j-silv/FPGA-based-Sudoku/schematics/bemicromax10_j5_pinout.PNG

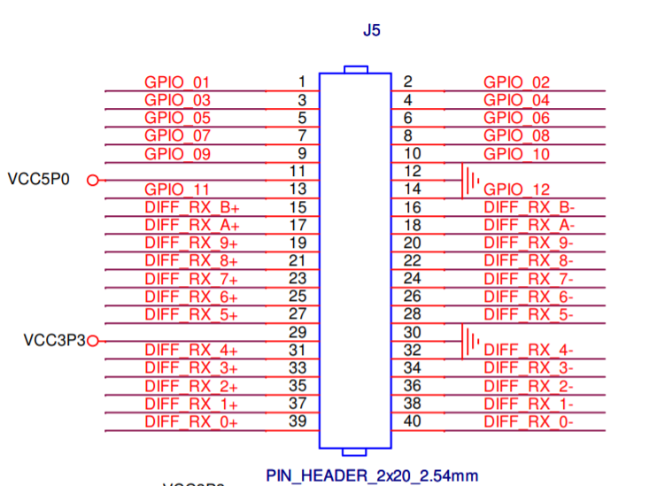
schematics/bemicromax10_j5_pinout.PNG
