j-silv/FPGA-based-Sudoku/altium/Source/Project Outputs for sudoku/png/sudoku_3d_top.png

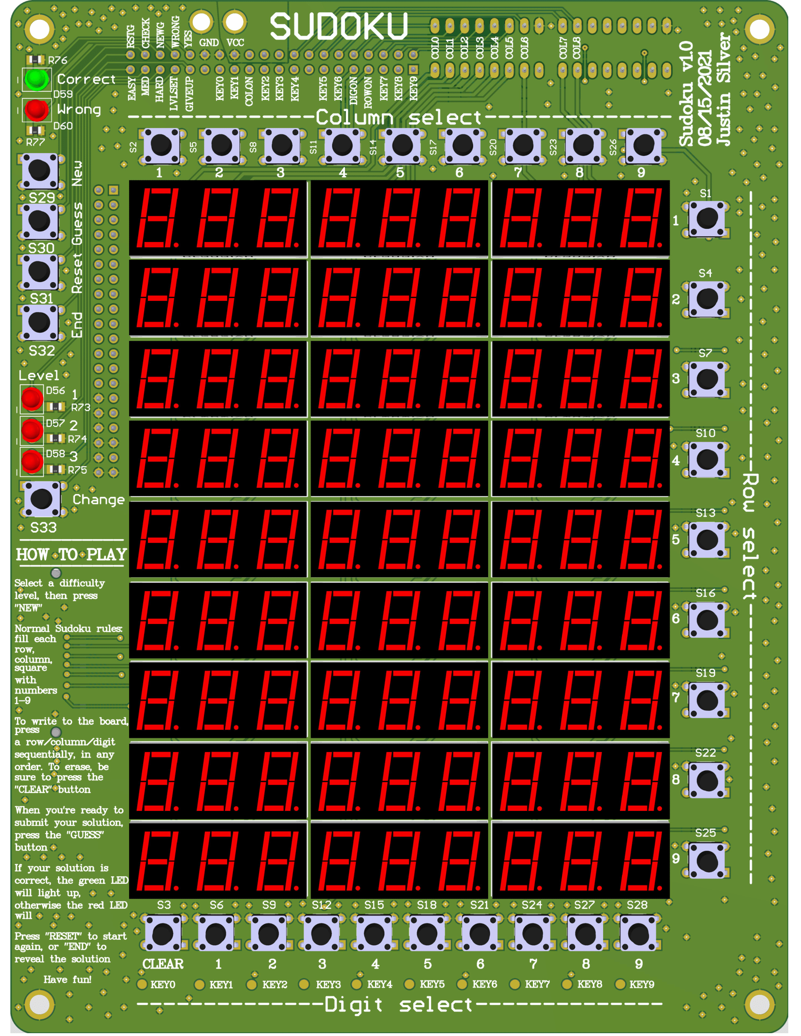
altium/Source/Project Outputs for sudoku/png/sudoku_3d_top.png
