j-silv/FPGA-based-Sudoku/README.md

# FPGA-based-Sudoku
Here you will find HDL, Quartus II, and LTspice files for my Intel MAX 10 FPGA-based Sudoku game.
