j-silv/FPGA-based-Sudoku/schematics/README.txt

This folder contains the schematic files for the Sudoku design.
When opened in Quartus II, these .bdf files show the HDL components connected together.
