j-silv/FPGA-based-Sudoku/LTspice/README.txt

In this folder, you will find circuit simulation (LTspice) files for various components of the Sudoku design
