j-silv/FPGA-based-Sudoku/HDL/README.txt

This folder contains the HDL files for each component in the Sudoku design (RAM, encoders, counters, etc.)
