j-silv/FPGA-based-Sudoku/symbols/README.txt

This folder contains the Quartus II symbol files that are created from their associated HDL files.
These symbols are used to create the .bdf schematics found in the schematics/ folder.
