j-silv/FPGA-based-Sudoku/scripts/pins/README.txt

This folder contains the pin assignment files for the Sudoku design. These assignments are made using TCL script files
that are executed via the Quartus II software.

For this project, the pins are set for a MAX 10 10M08DAF484 FPGA development board.
