j-silv/FPGA-based-Sudoku/altium/Source/Project Outputs for sudoku/png/sudoku_3d.png

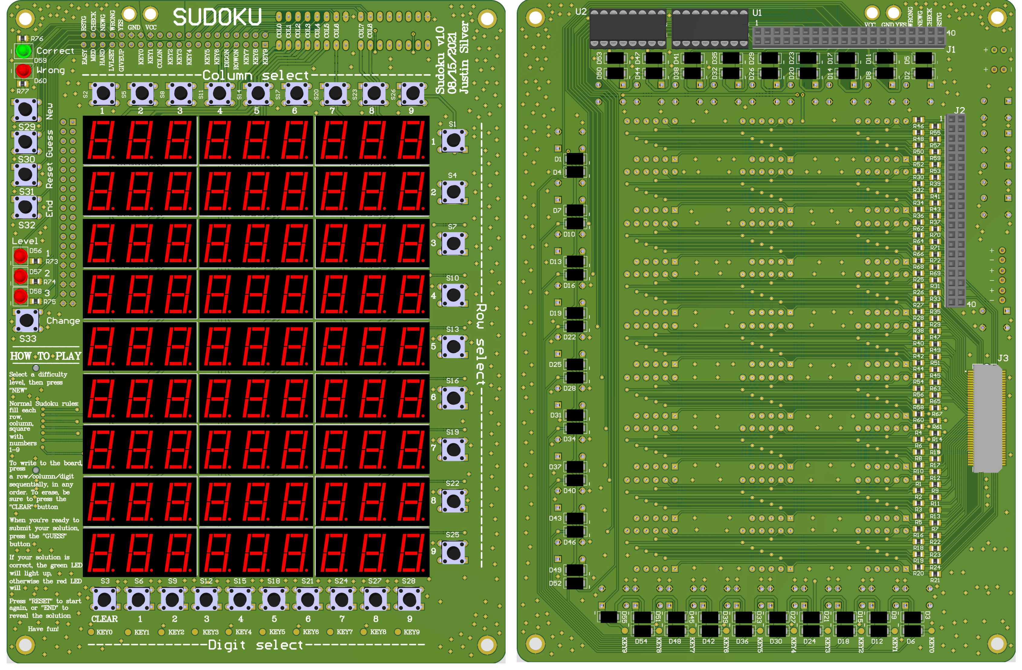
altium/Source/Project Outputs for sudoku/png/sudoku_3d.png
