j-silv/FPGA-based-Sudoku/altium/Source/Project Outputs for sudoku/png/sudoku_3d_and_2d_pcb.png

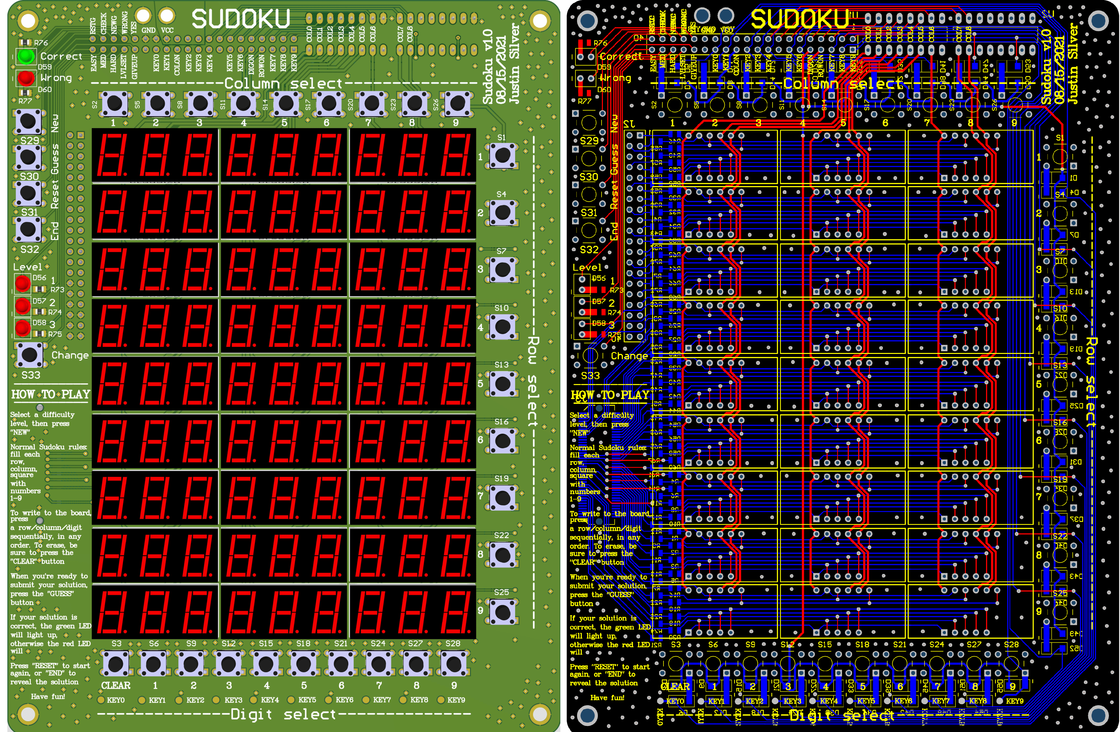
altium/Source/Project Outputs for sudoku/png/sudoku_3d_and_2d_pcb.png
