j-silv/FPGA-based-Sudoku/altium/Source/Project Outputs for sudoku/png/sudoku_3d_bot.png

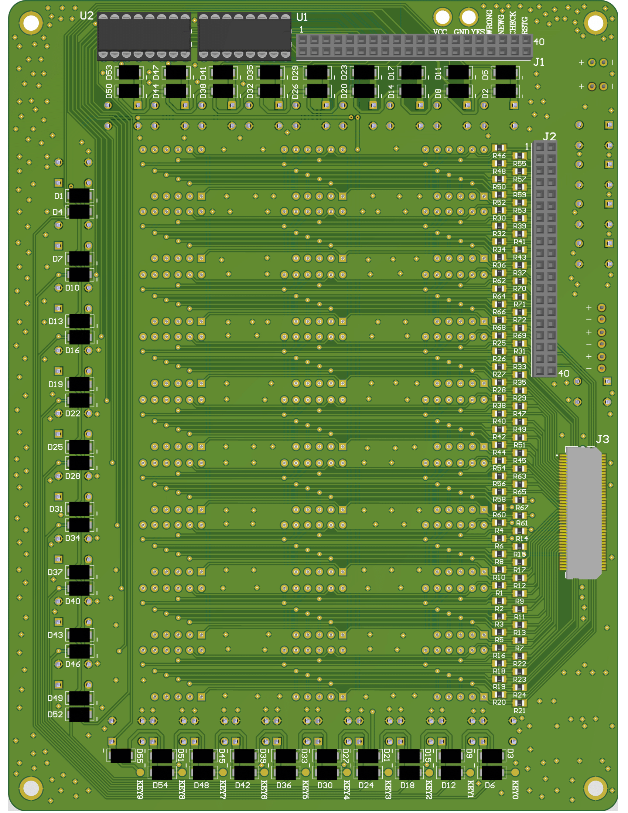
altium/Source/Project Outputs for sudoku/png/sudoku_3d_bot.png
