j-silv/FPGA-based-Sudoku/altium/Source/Project Outputs for sudoku/png/sudoku_all_nopoly_side.png

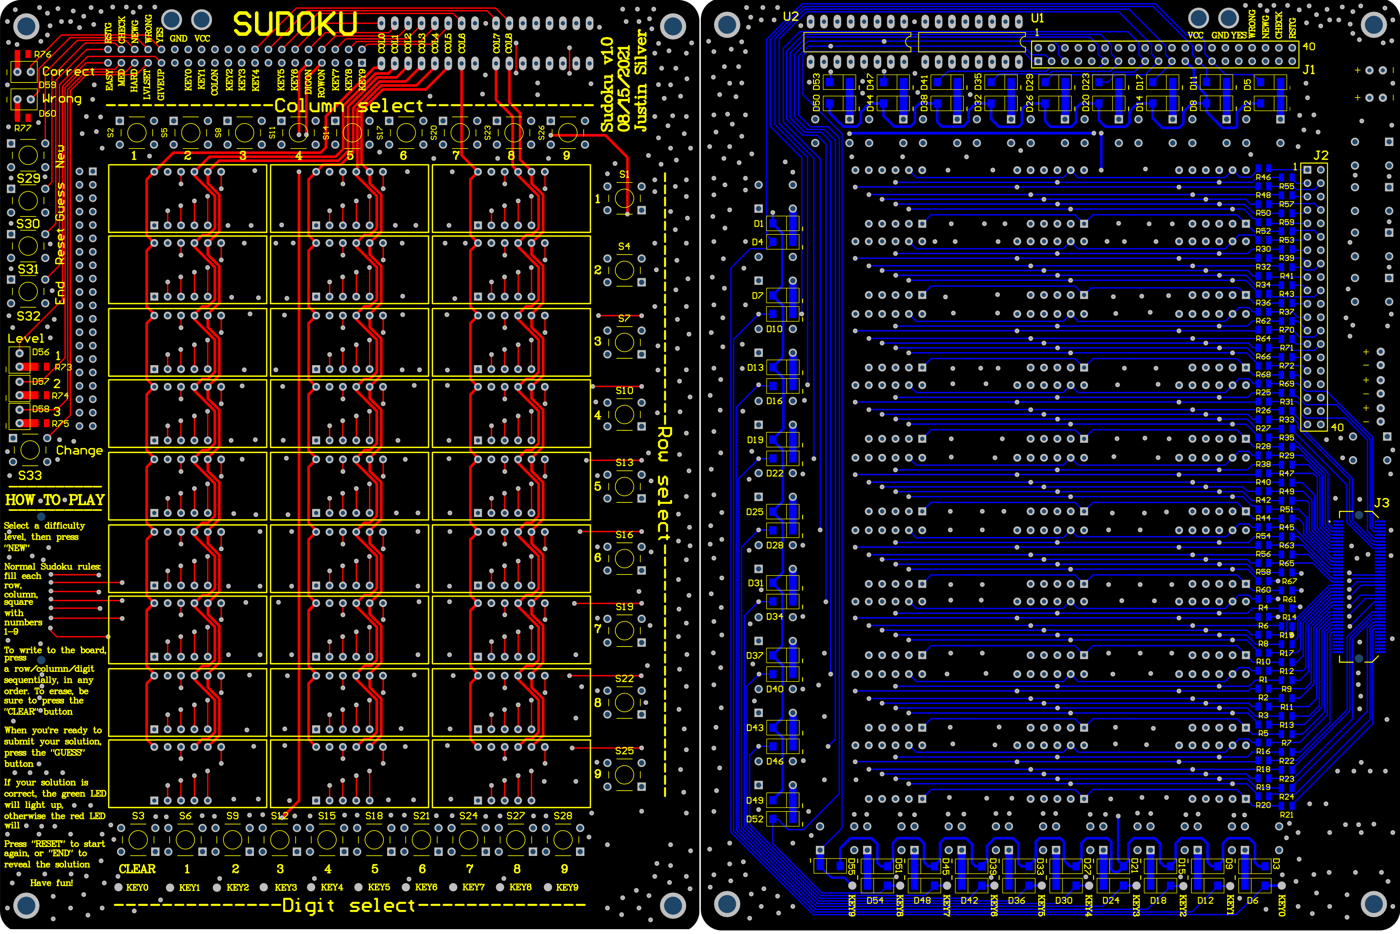
altium/Source/Project Outputs for sudoku/png/sudoku_all_nopoly_side.png
