j-silv/FPGA-based-Sudoku/altium/Source/Project Outputs for sudoku/png/sudoku_bot_nopoly.png

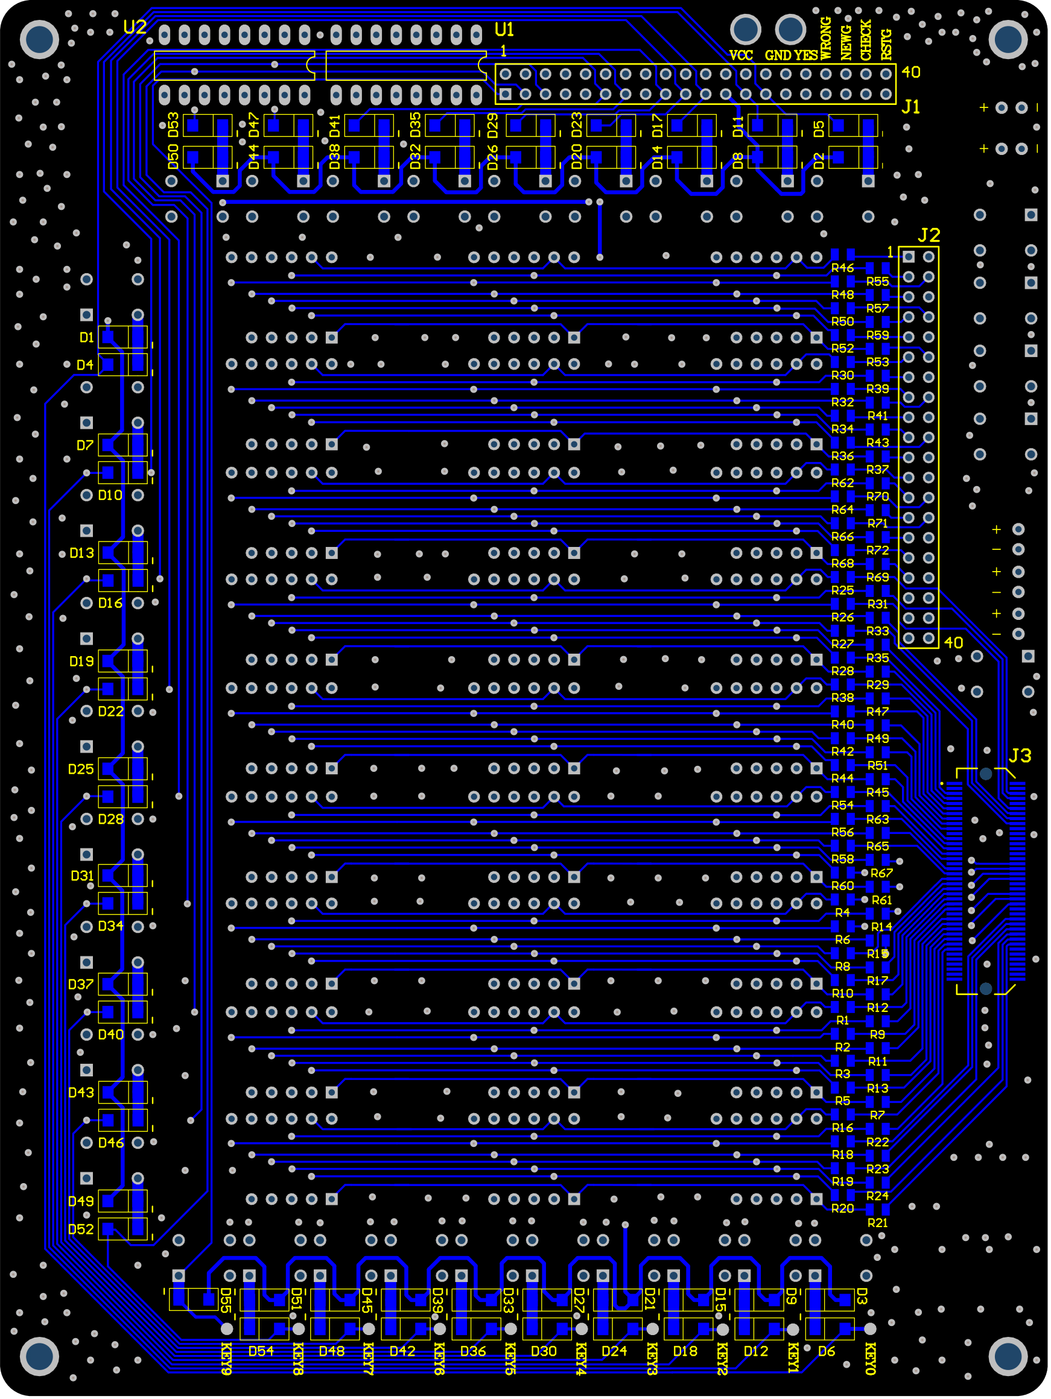
altium/Source/Project Outputs for sudoku/png/sudoku_bot_nopoly.png
