j-silv/FPGA-based-Sudoku/altium/Source/Project Outputs for sudoku/png/sudoku_bot_poly.png

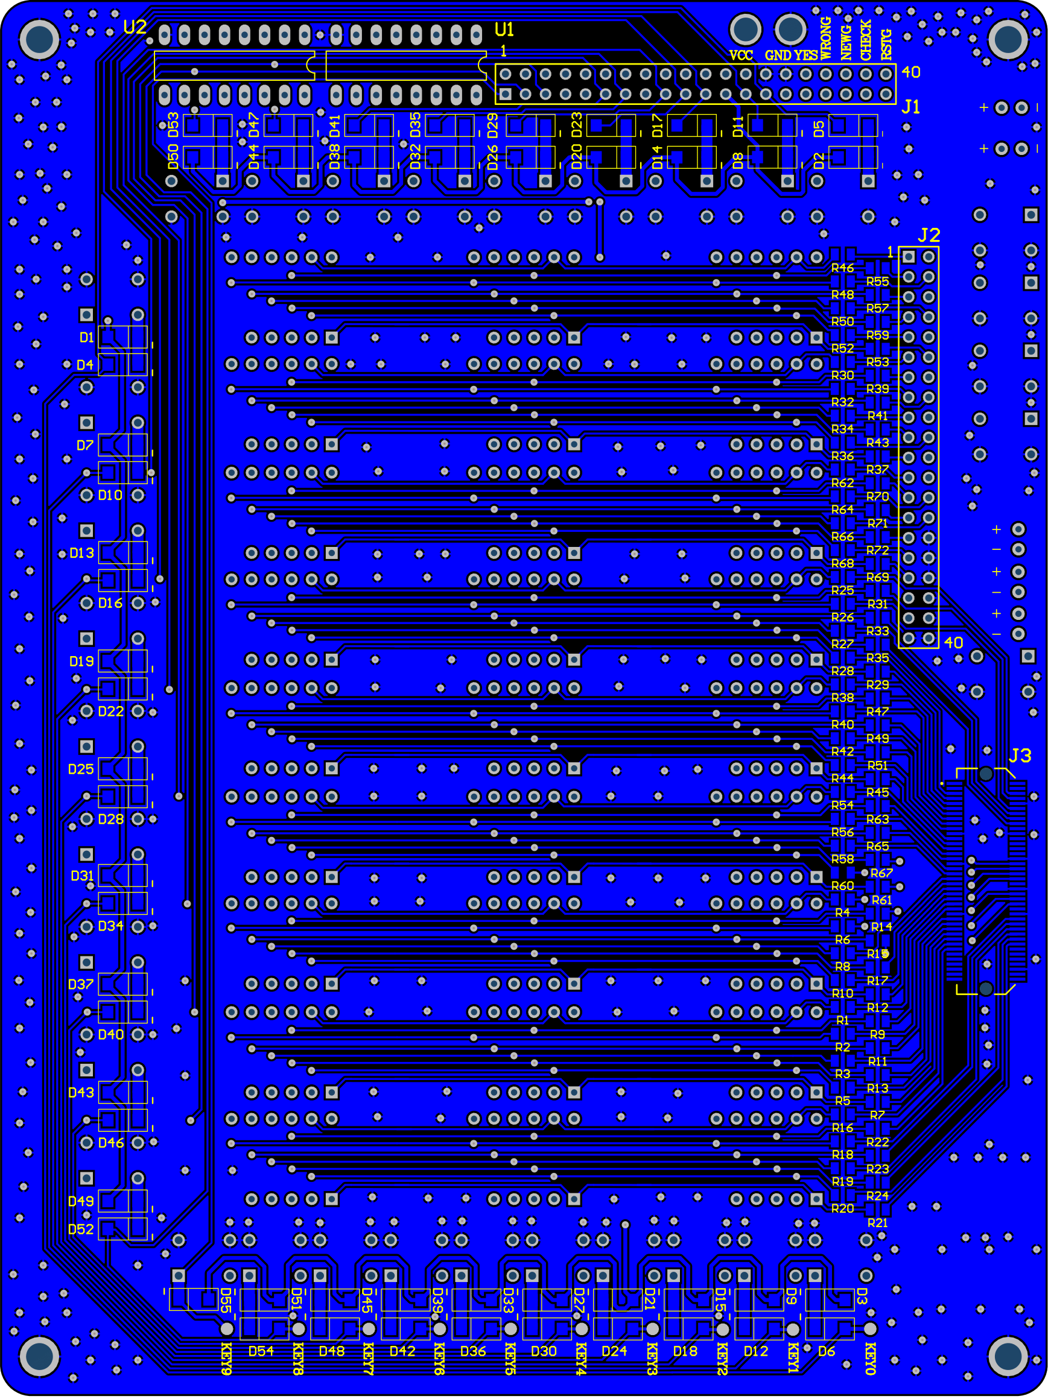
altium/Source/Project Outputs for sudoku/png/sudoku_bot_poly.png
