j-silv/FPGA-based-Sudoku/altium/Source/Project Outputs for sudoku/png/sudoku_fpga_connectors.png

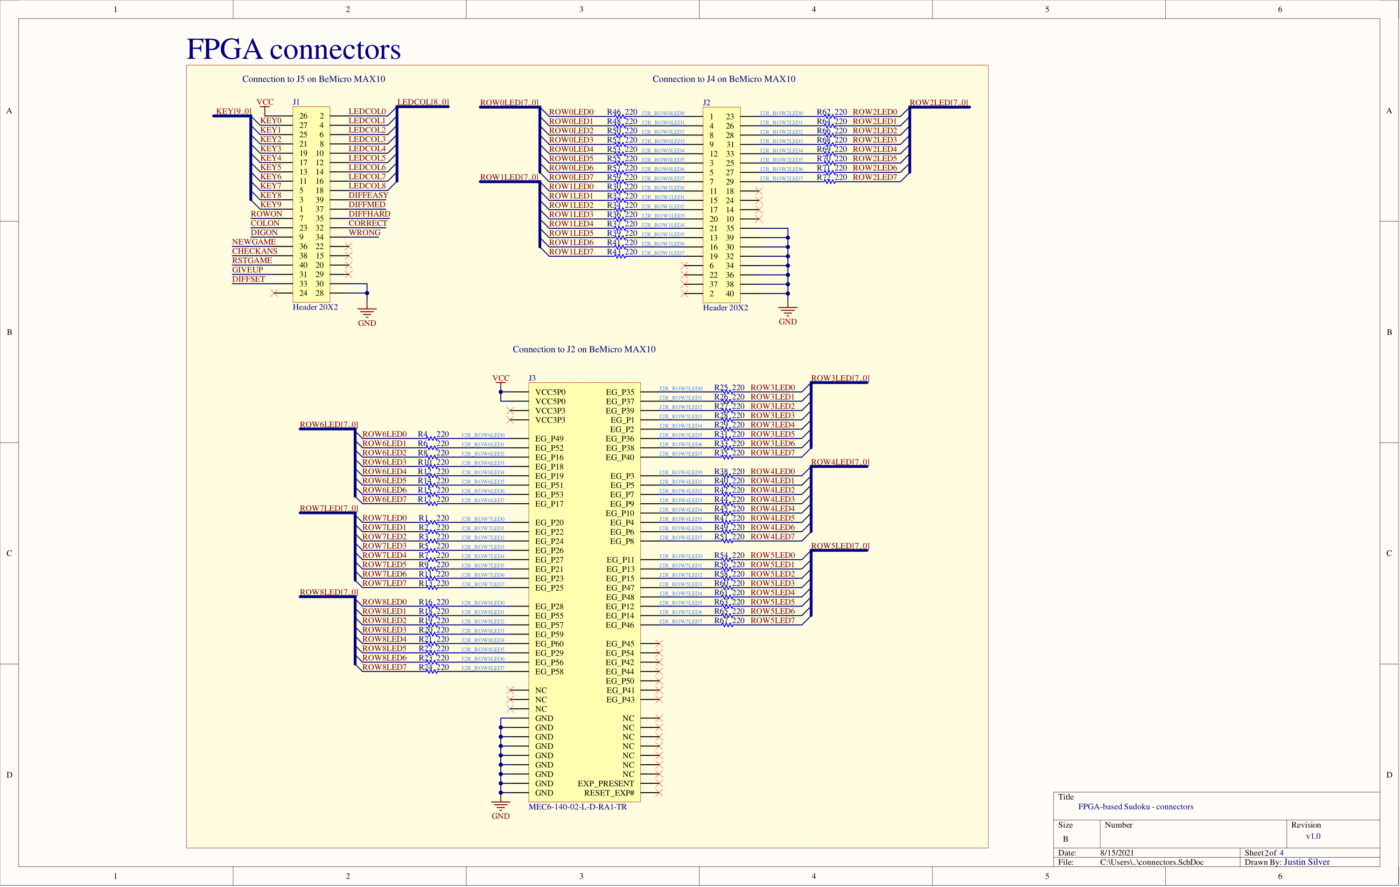
altium/Source/Project Outputs for sudoku/png/sudoku_fpga_connectors.png
