j-silv/FPGA-based-Sudoku/altium/Source/Project Outputs for sudoku/png/sudoku_grid_display.png

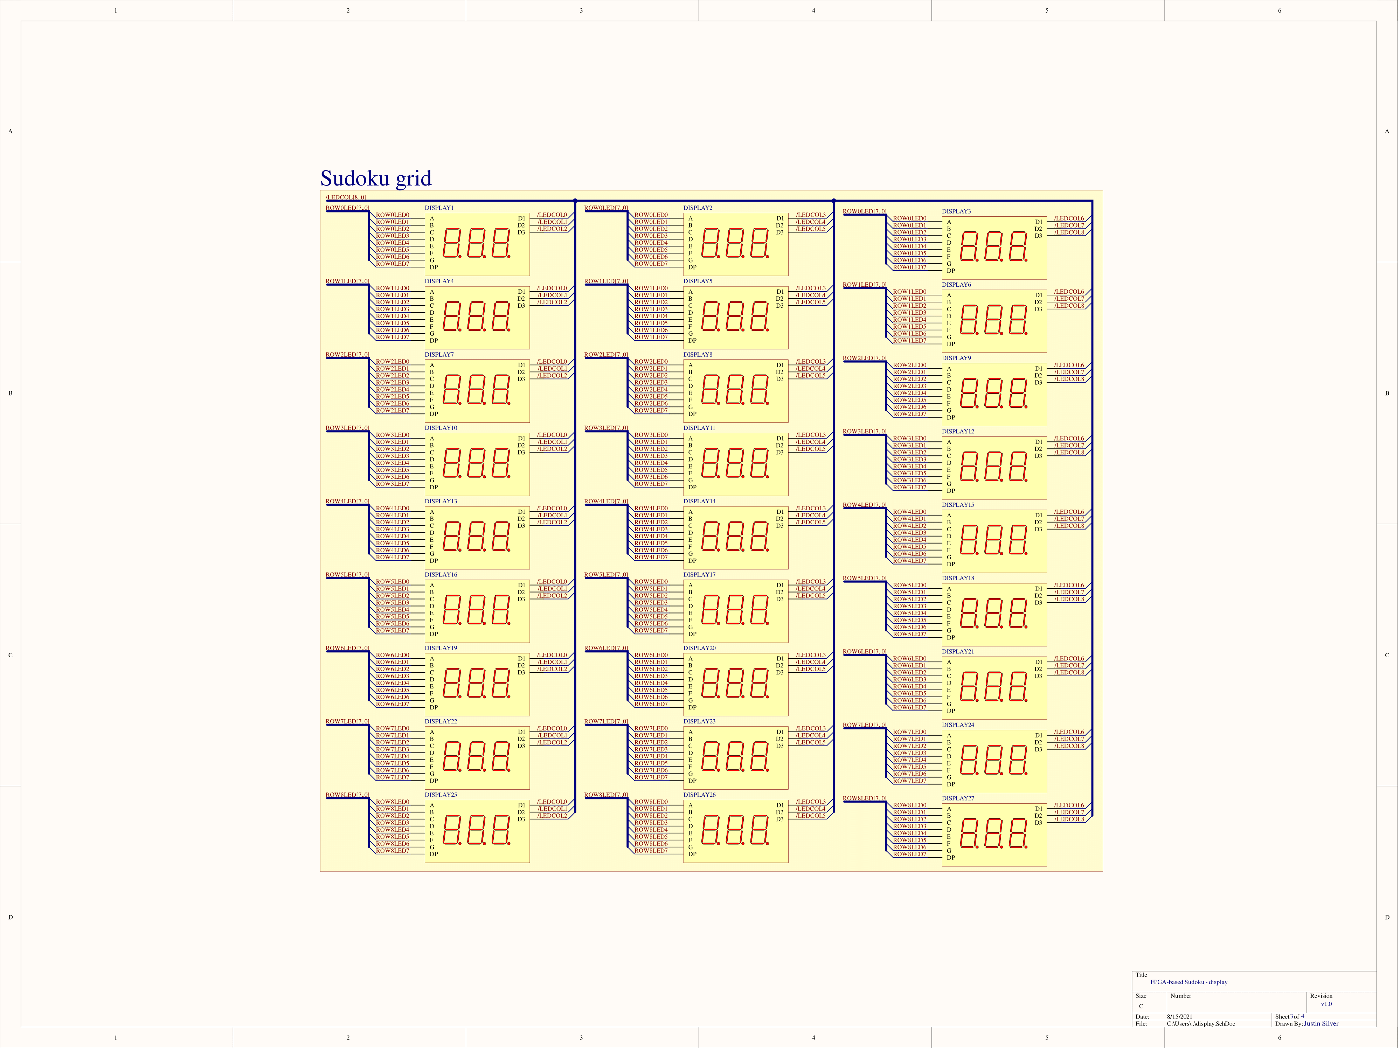
altium/Source/Project Outputs for sudoku/png/sudoku_grid_display.png
