j-silv/FPGA-based-Sudoku/altium/Source/Project Outputs for sudoku/png/sudoku_keyboard.png

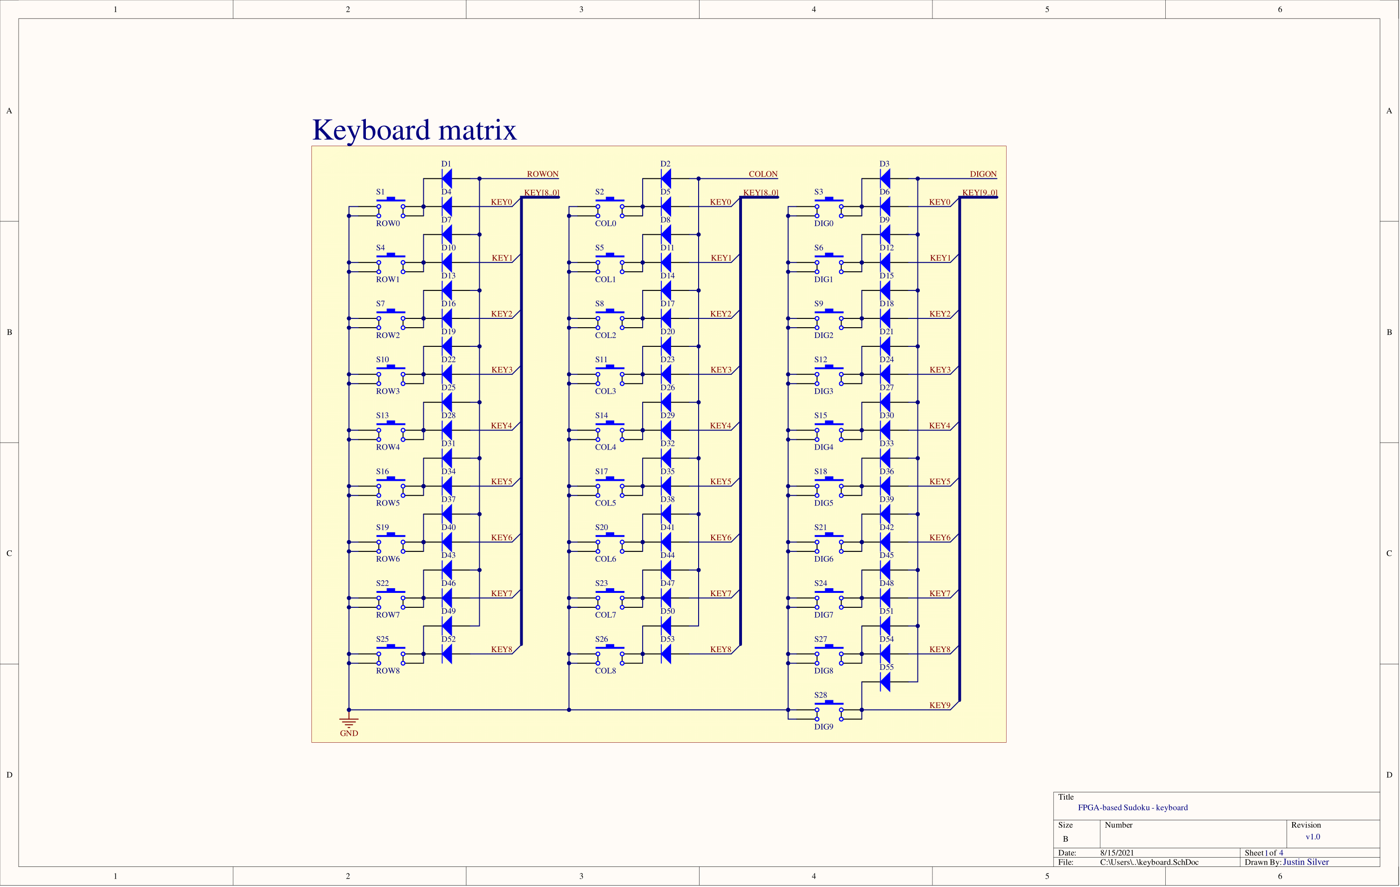
altium/Source/Project Outputs for sudoku/png/sudoku_keyboard.png
