j-silv/FPGA-based-Sudoku/altium/Source/Project Outputs for sudoku/png/sudoku_misc.png

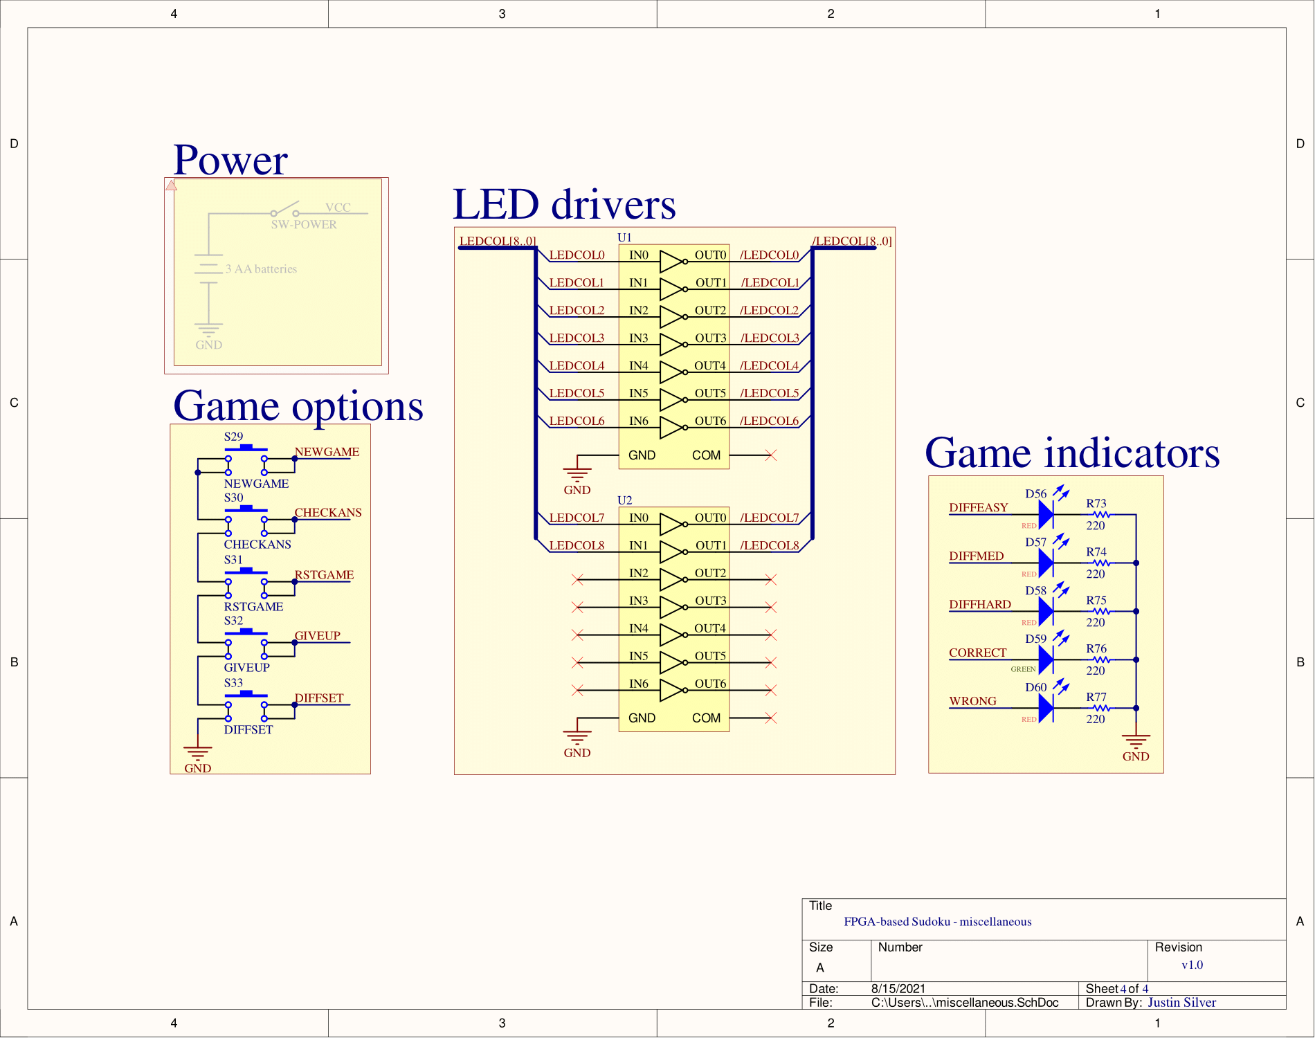
altium/Source/Project Outputs for sudoku/png/sudoku_misc.png
