j-silv/FPGA-based-Sudoku/altium/Source/Project Outputs for sudoku/png/sudoku_top_poly.png

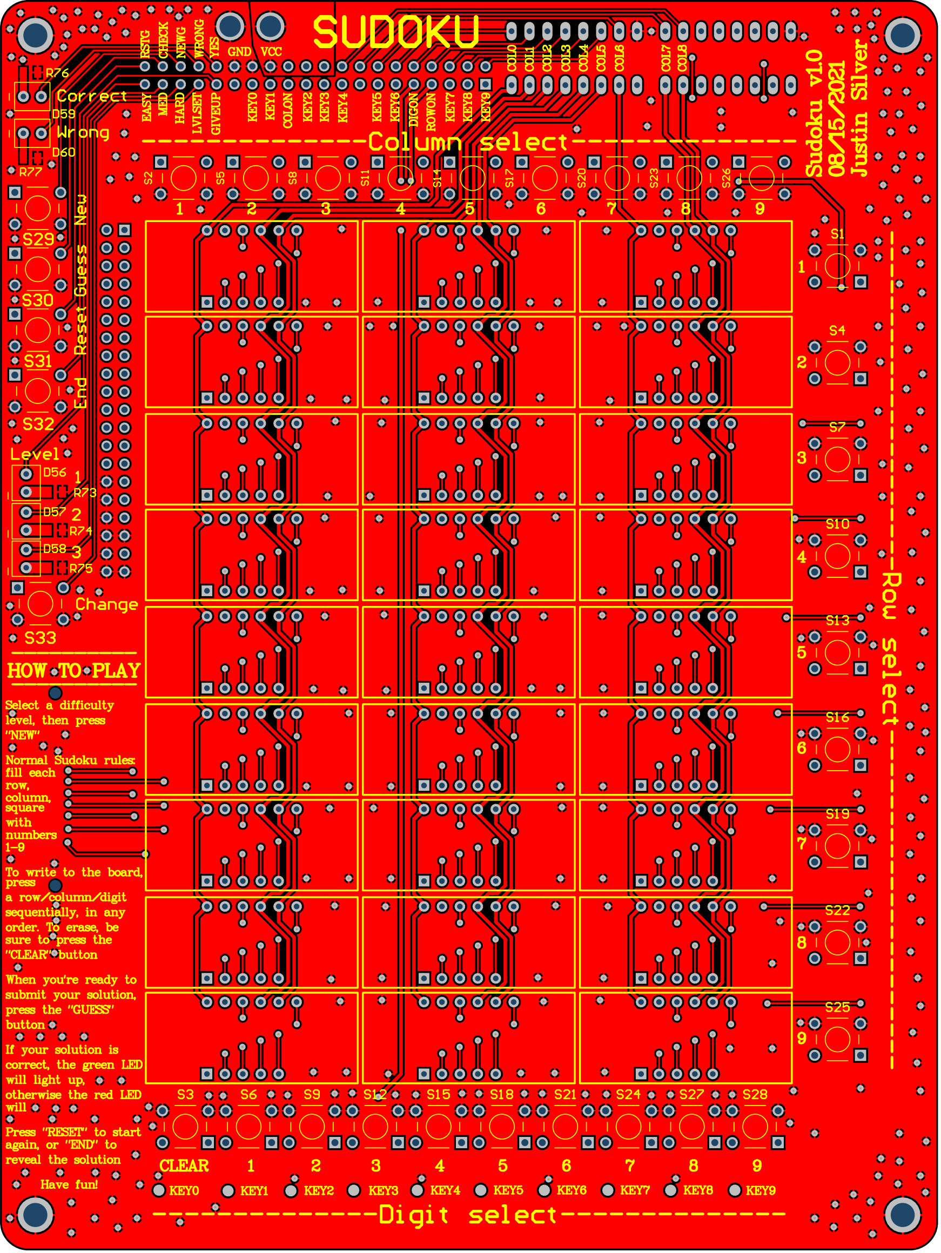
altium/Source/Project Outputs for sudoku/png/sudoku_top_poly.png
