j-silv/FPGA-based-Sudoku/schematics/bemicromax10_j4_pinout.PNG

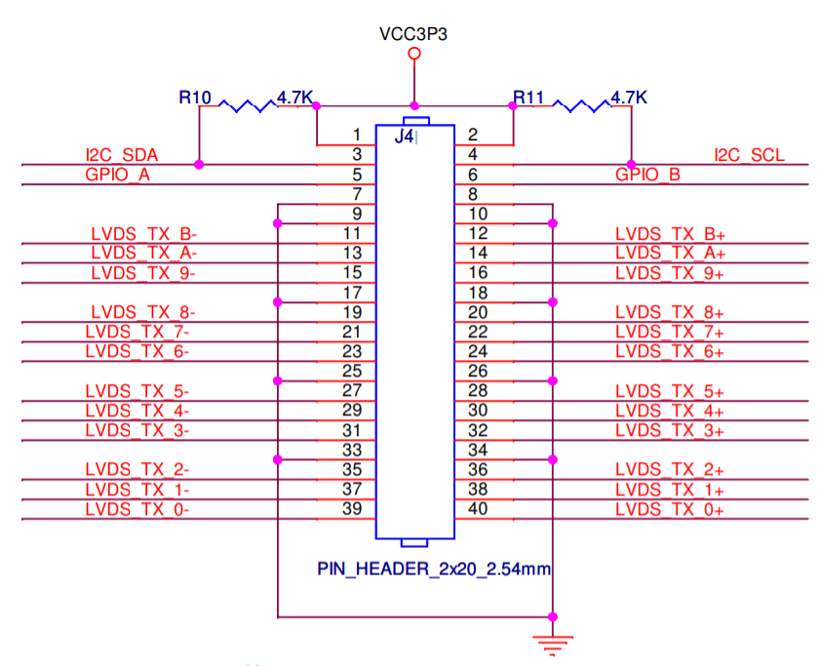
schematics/bemicromax10_j4_pinout.PNG
