j-silv/FPGA-based-Sudoku/testbenches/README.txt

This folder contains testbench code for simulating and testing the Sudoku design in ModelSim (Altera).
