j-silv/FPGA-based-Sudoku/debug/README.txt

This folder contains the various files needed to debug/test the Sudoku design with actual hardware
