j-silv/FPGA-based-Sudoku/altium/Source/Project Outputs for sudoku/schematic/sudoku.PDF

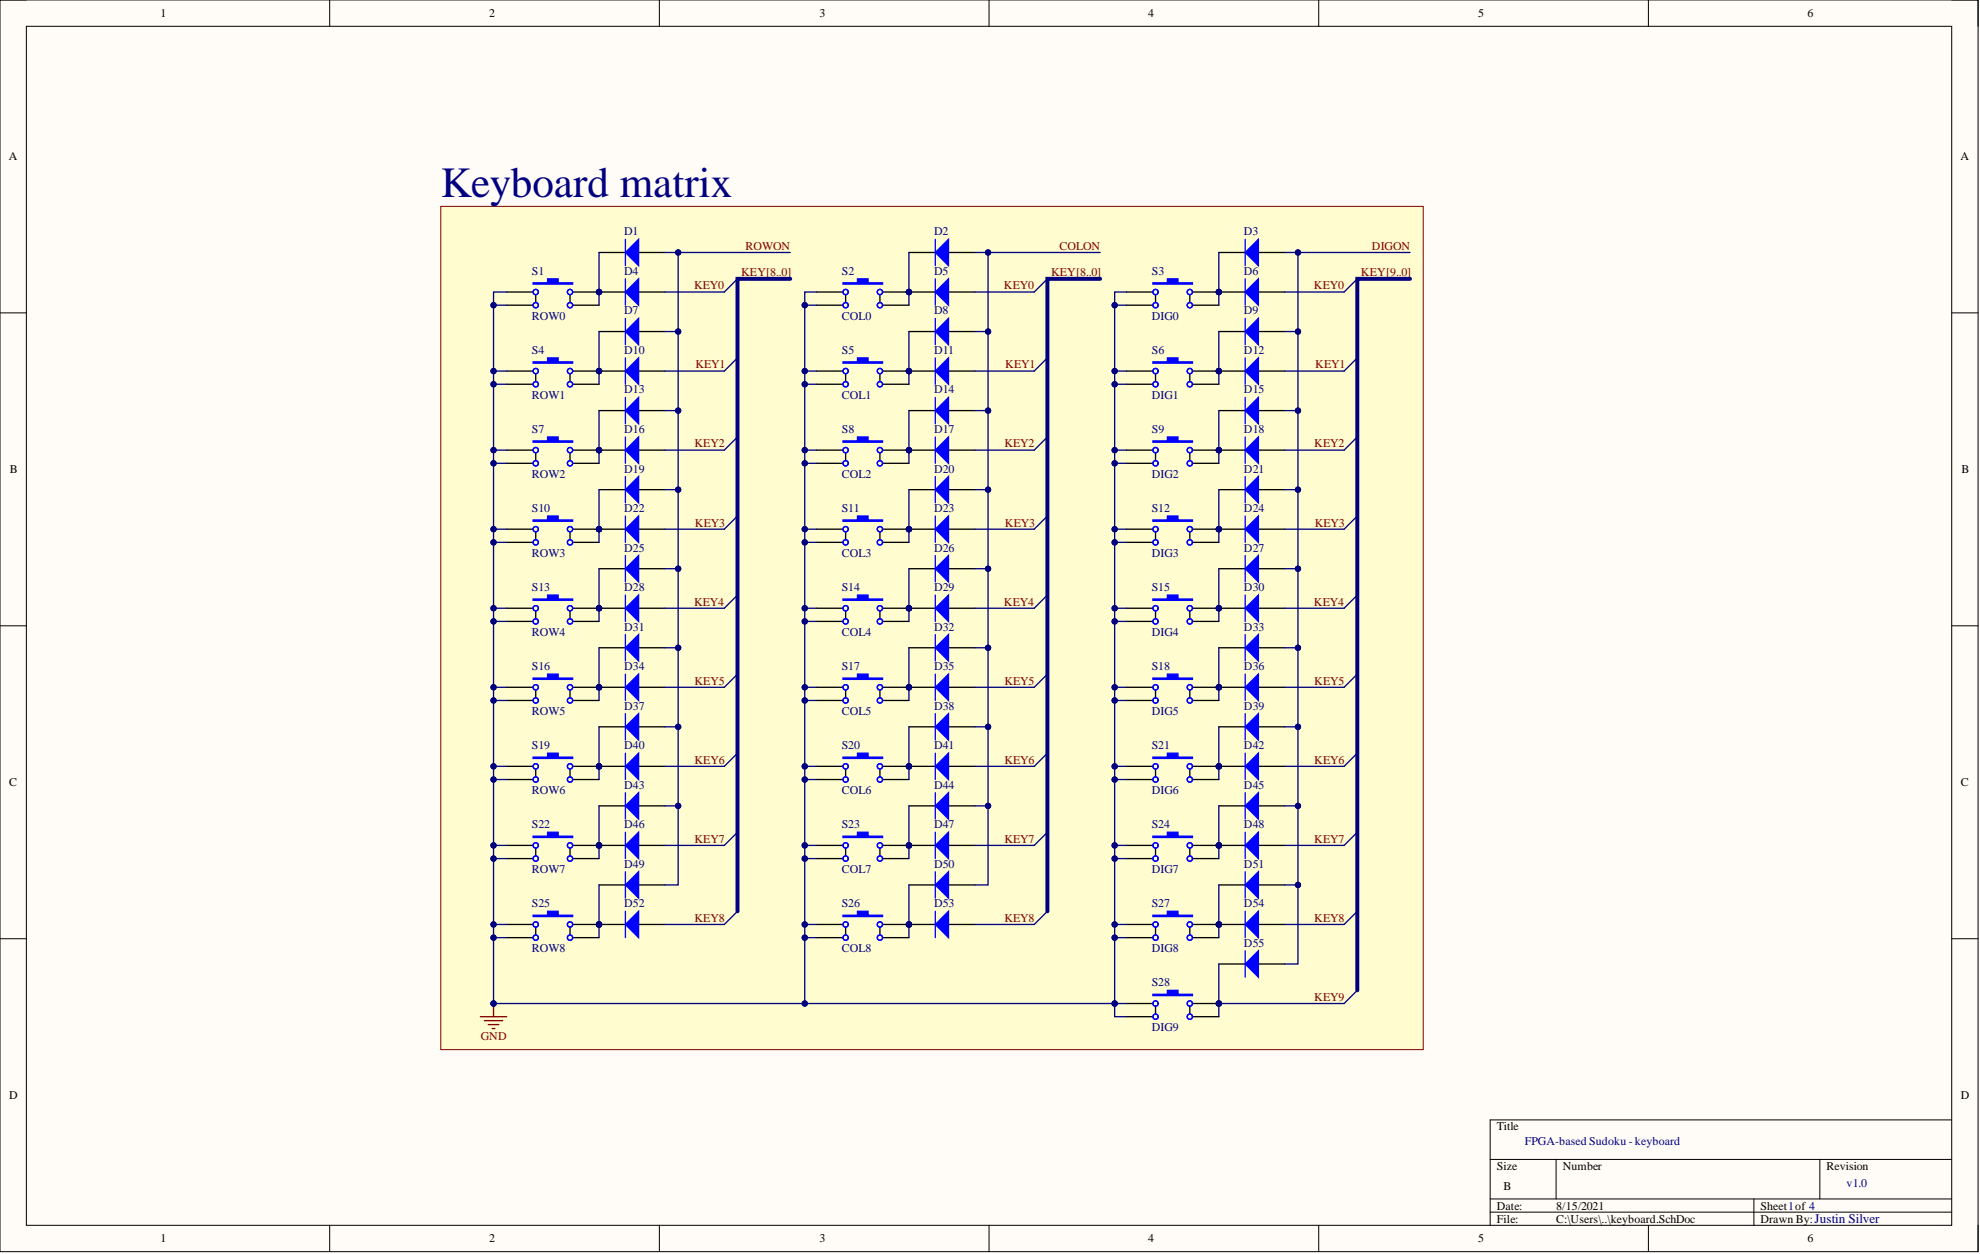
[picture p18: page 1]

Title
FPGA-based Sudoku - keyboard

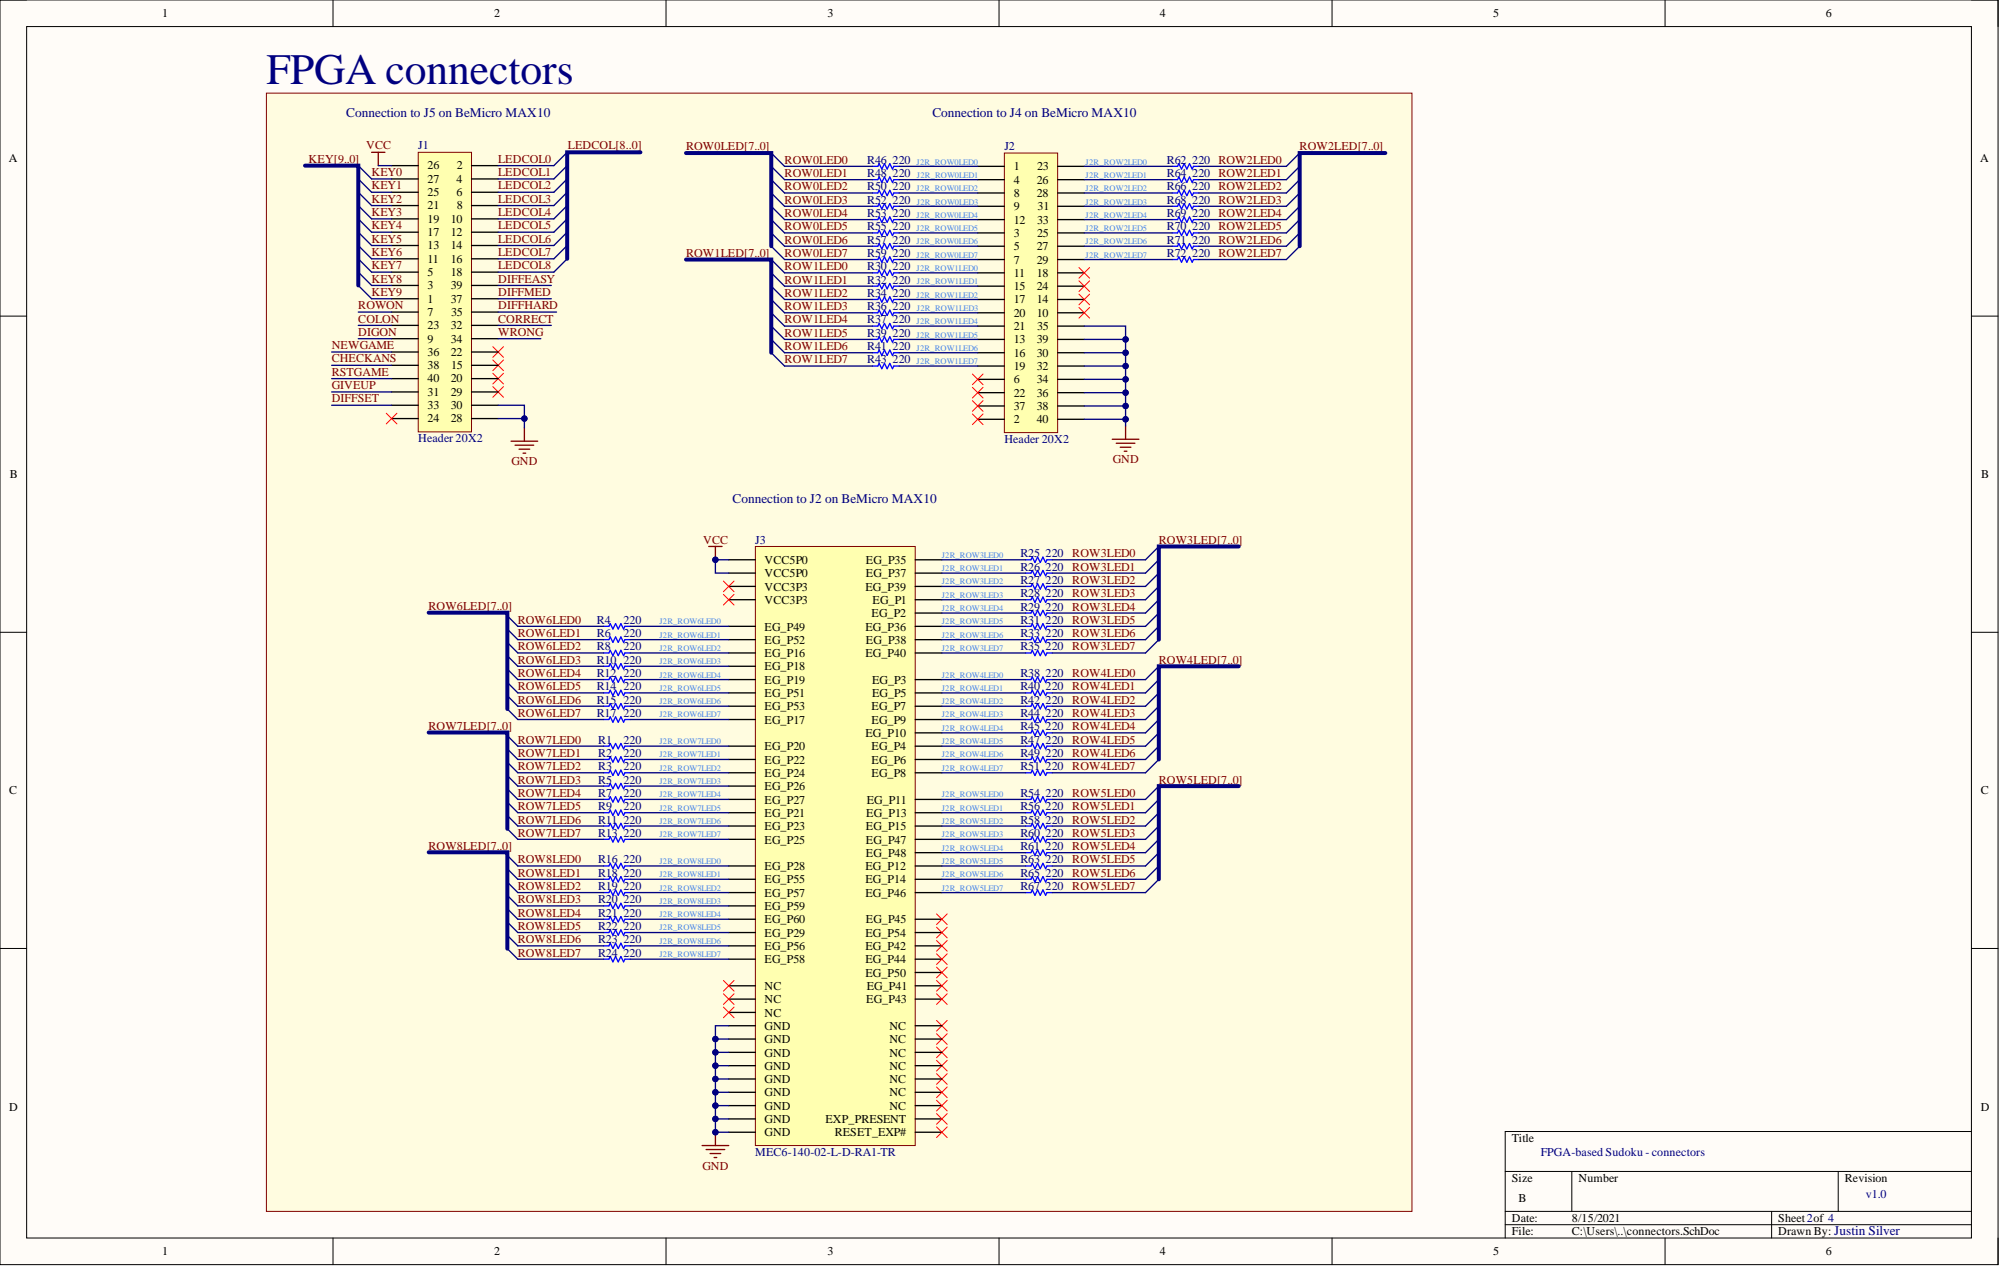
[picture p19: page 2]

Connection to J2 on BeMicro MAX10

Title
FPGA-based Sudoku - connectors

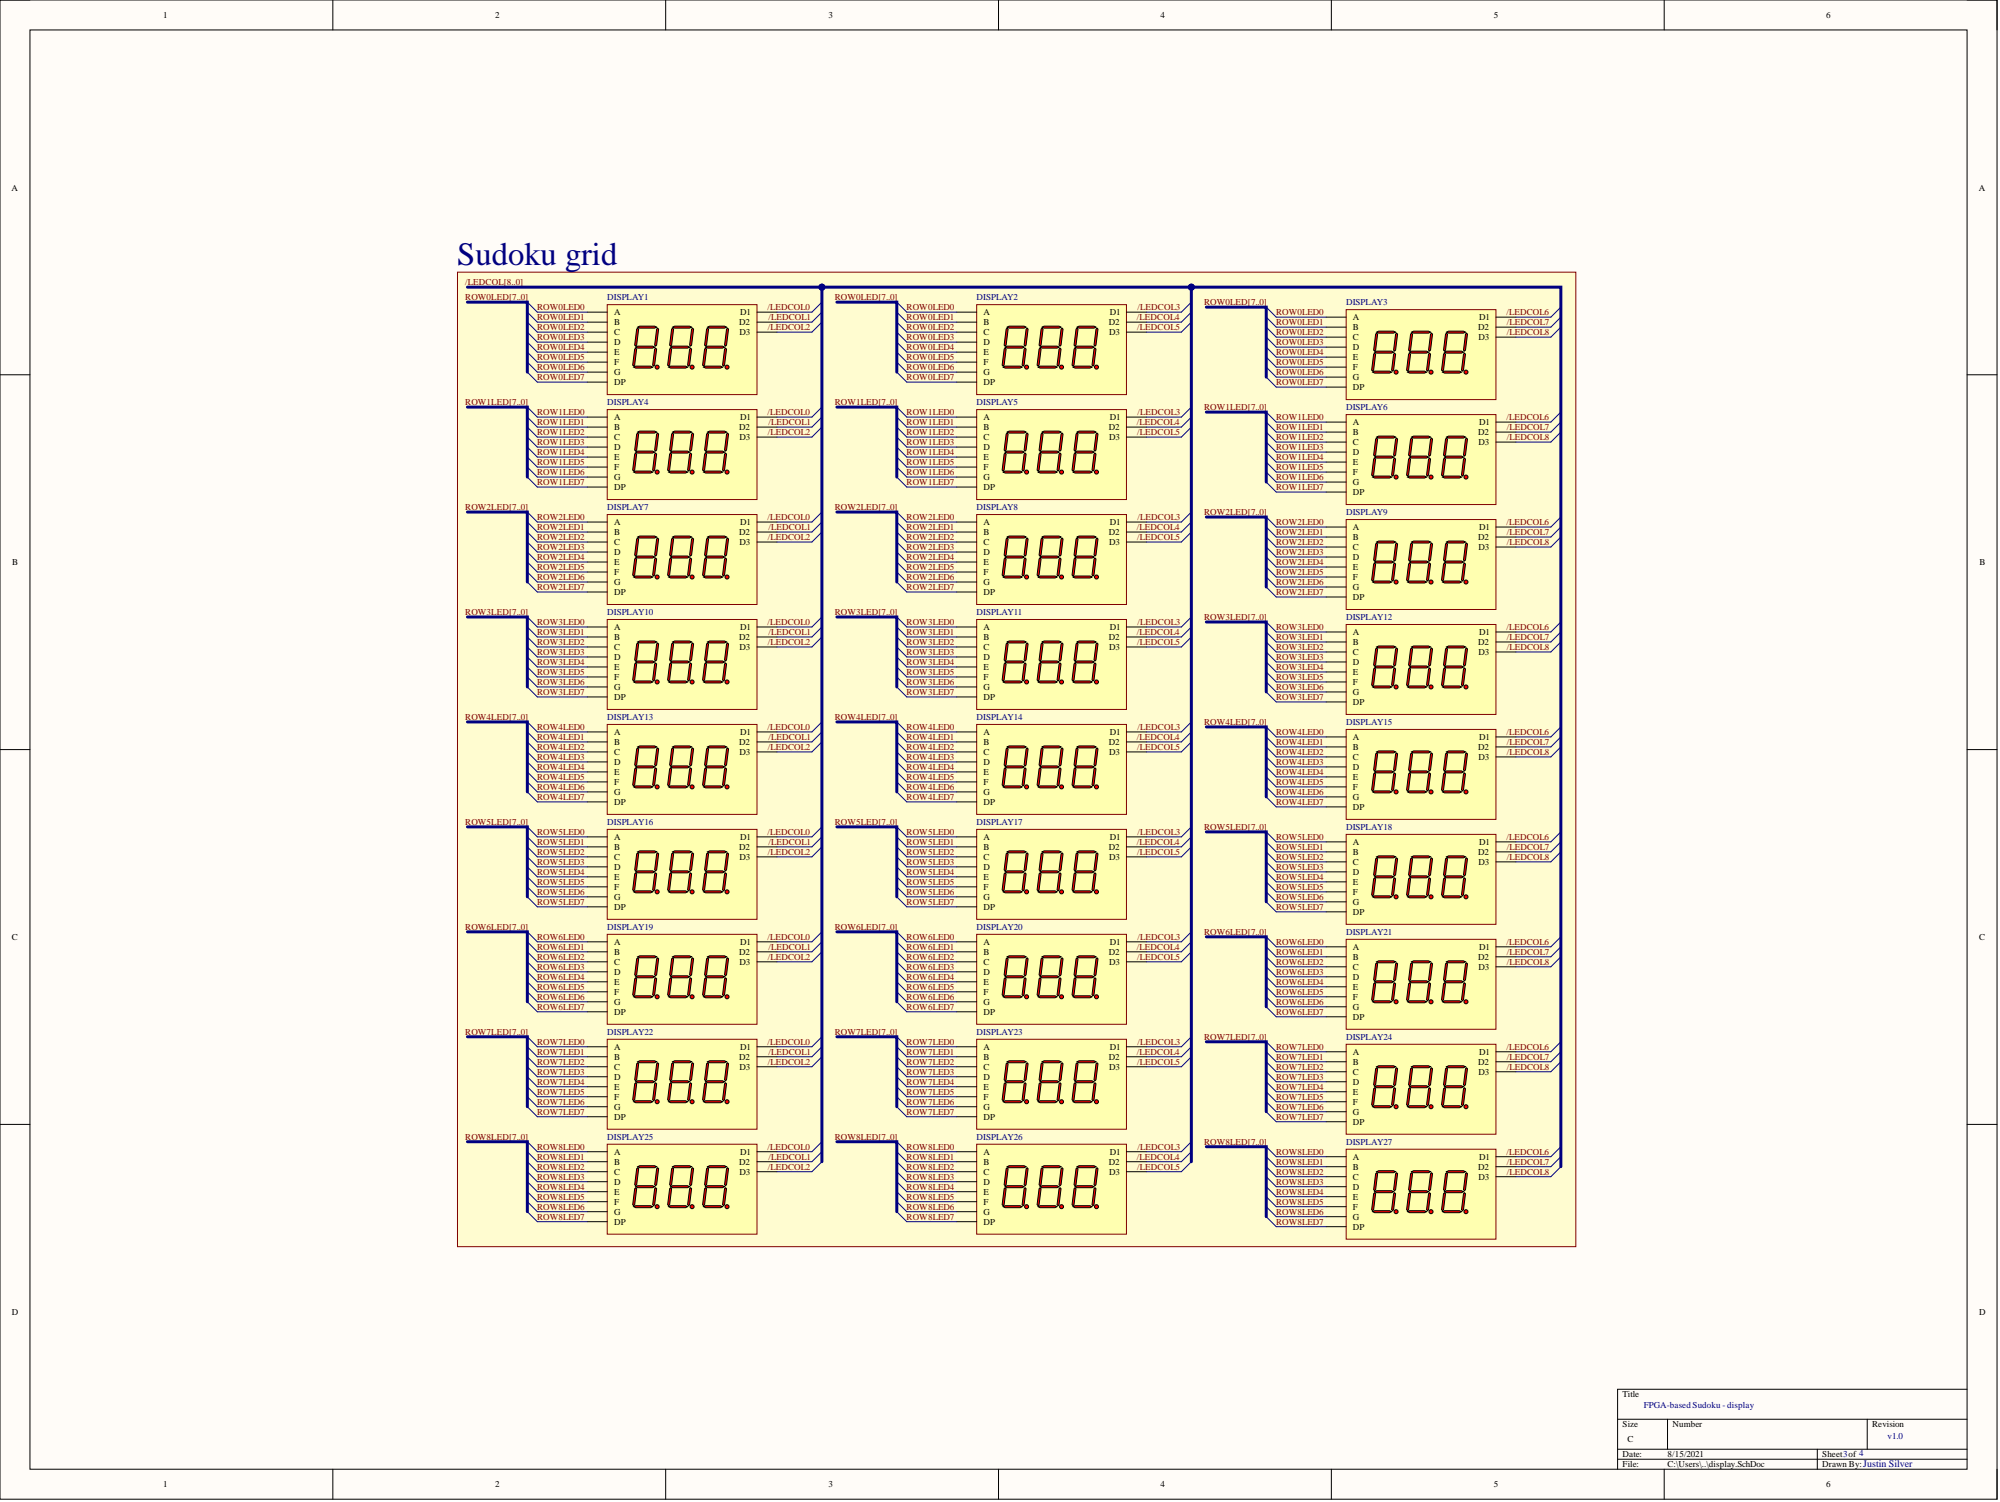
[picture p20: page 3]

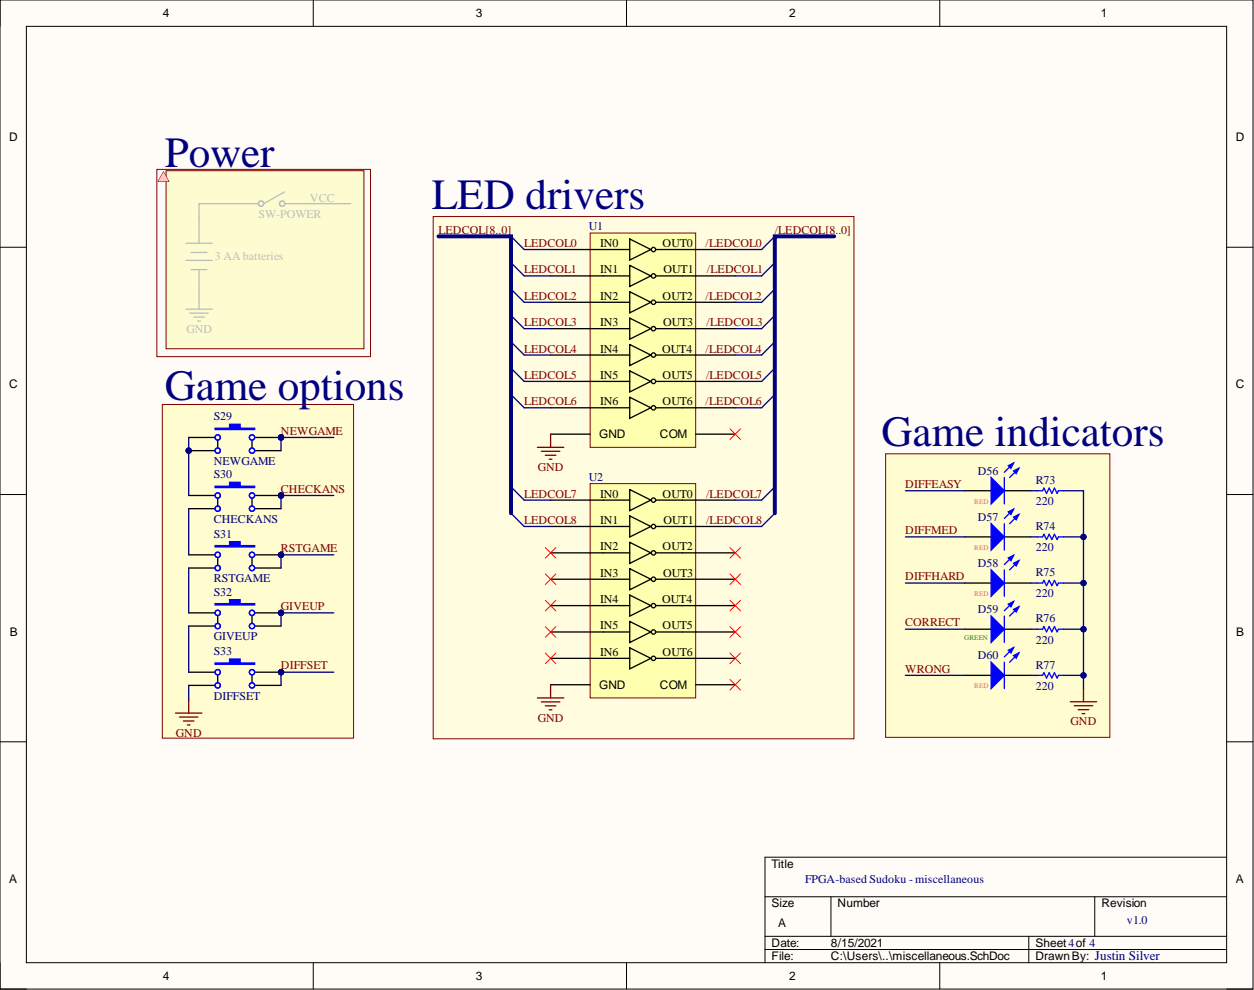
[picture p21: page 4]
