j-silv/FPGA-based-Sudoku/LTspice/LED_driver/ULN2003A_test.asc

D1: LED; LED1
D2: LED; LED1
D3: LED; LED1
D4: LED; LED1
D5: LED; LED1
D6: LED; LED1
D7: LED; LED1
D8: LED; LED1
D9: LED; LED1
D10: LED; LED1
D11: LED; LED1
D12: LED; LED1
D13: LED; LED1
D14: LED; LED1
D15: LED; LED1
D16: LED; LED1
D17: LED; LED1
D18: LED; LED1
D19: LED; LED1
D20: LED; LED1
D21: LED; LED1
D22: LED; LED1
D23: LED; LED1
D24: LED; LED1
D25: LED; LED1
D26: LED; LED1
D27: LED; LED1
D28: LED; LED1
D29: LED; LED1
D30: LED; LED1
D31: LED; LED1
D32: LED; LED1
D33: LED; LED1
D34: LED; LED1
D35: LED; LED1
D36: LED; LED1
D37: LED; LED1
D38: LED; LED1
D39: LED; LED1
D40: LED; LED1
D41: LED; LED1
D42: LED; LED1
D43: LED; LED1
D44: LED; LED1
D45: LED; LED1
D46: LED; LED1
D47: LED; LED1
D48: LED; LED1
D49: LED; LED1
D50: LED; LED1
D51: LED; LED1
D52: LED; LED1
D53: LED; LED1
D54: LED; LED1
D55: LED; LED1
D56: LED; LED1
D57: LED; LED1
D58: LED; LED1
D59: LED; LED1
D60: LED; LED1
D61: LED; LED1
D62: LED; LED1
D63: LED; LED1
D64: LED; LED1
D65: LED; LED1
D66: LED; LED1
D67: LED; LED1
D68: LED; LED1
D69: LED; LED1
D70: LED; LED1
D71: LED; LED1
D72: LED; LED1
D73: LED; LED1
D74: LED; LED1
D75: LED; LED1
D76: LED; LED1
D77: LED; LED1
D78: LED; LED1
Q1: npn; ULN2003A
Q2: npn; ULN2003A
R1: res; {R}
R2: res; {R}
R3: res; {R}
R4: res; {R}
R5: res; {R}
R6: res; {R}
R7: res; {R}
R8: res; 2.7k
R9: res; 7.2k
R10: res; 3k
R11: res; {R}
R12: res; {R}
R13: res; {R}
R14: res; {R}
R15: res; {R}
R16: res; {R}
R17: res; {R}
R18: res; {R}
R19: res; {R}
R20: res; {R}
R21: res; {R}
R22: res; {R}
R23: res; {R}
R24: res; {R}
R25: res; {R}
R26: res; {R}
R27: res; {R}
R28: res; {R}
R29: res; {R}
R30: res; {R}
R31: res; {R}
R32: res; {R}
R33: res; {R}
R34: res; {R}
R35: res; {R}
R36: res; {R}
R37: res; {R}
R38: res; {R}
R39: res; {R}
R40: res; {R}
R41: res; {R}
R42: res; {R}
R43: res; {R}
R44: res; {R}
R45: res; {R}
R46: res; {R}
R47: res; {R}
R48: res; {R}
R49: res; {R}
R50: res; {R}
R51: res; {R}
R52: res; {R}
R53: res; {R}
R54: res; {R}
R55: res; {R}
R56: res; {R}
R57: res; {R}
R58: res; {R}
R59: res; {R}
R60: res; {R}
R61: res; {R}
R62: res; {R}
R63: res; {R}
R64: res; {R}
R65: res; {R}
R66: res; {R}
R67: res; {R}
R68: res; {R}
R69: res; {R}
R70: res; {R}
R71: res; {R}
R72: res; {R}
R73: res; {R}
R74: res; {R}
R75: res; {R}
R76: res; {R}
R77: res; {R}
R78: res; {R}
R79: res; {R}
R80: res; {R}
R81: res; {R}
V1: voltage; 3.3
V2: voltage; 3.3
Named nets: 0, GPIO_FPGA, Vcc
.param R=220
.tran 100us
*Typ RED GaAs LED: Vf=1.7V Vr=4V If=40mA trr=3uS
.MODEL LED1 D (Vfwd=2.0 IS=93.2P RS=42M N=3.73 BV=4 IBV=10U
+ CJO=2.97P VJ=.75 M=.333 TT=4.32U)
.MODEL ULN2003A NPN (BF=32)
