j-silv/FPGA-based-Sudoku/LTspice/LED_driver/TD62504P_test.asc

D1: LED
D2: LED
D3: LED
D4: LED
D5: LED
D6: LED
D7: LED
Q1: npn
R1: res; {R}
R2: res; {R}
R3: res; {R}
R4: res; {R}
R5: res; {R}
R6: res; {R}
R7: res; {R}
R8: res; 10k
R9: res; 10k
V1: voltage; 3.3
V2: voltage; 2.5
Named nets: 0, GPIO_FPGA, Vcc
.param R=220
.tran 100us
