j-silv/FPGA-based-Sudoku/LTspice/LED_driver/ULN2064B_test.asc

D1: LED
D2: LED
D3: LED
D4: LED
D5: LED
D6: LED
D7: LED
Q1: npn
Q2: npn
R1: res; {R}
R2: res; {R}
R3: res; {R}
R4: res; {R}
R5: res; {R}
R6: res; {R}
R7: res; {R}
R8: res; 350
R9: res; 7.2k
R10: res; 3k
V1: voltage; 2.5
V2: voltage; 2.5
Named nets: 0, GPIO_FPGA, Vcc
.param R = 220
.tran 100us
