j-silv/FPGA-based-Sudoku/LTspice/LED_driver/ULN2003A_calculations.asc

D1: LED; LED1
Q1: npn; ULN2003A
Q2: npn; ULN2003A
R1: res; 7.2k
R2: res; 3k
RB: res; 2.7k
RS: res; {R/Nsegments}
V1: voltage; 3.3
V2: voltage; 3.3
Named nets: 0, VIN, VCC
.param Nsegments=1 R=220
.tran 100us
*Typ RED GaAs LED: Vf=1.7V Vr=4V If=40mA trr=3uS
.MODEL LED1 D (Vfwd=2.0 IS=93.2P RS=42M N=3.73 BV=4 IBV=10U
+ CJO=2.97P VJ=.75 M=.333 TT=4.32U)
.MODEL ULN2003A NPN (BF=32 )
LED model
Darlington pair model
Simulation
