j-silv/FPGA-based-Sudoku/LTspice/keyboard/keyboard.asc

D13: diode
D14: diode
D15: diode
D16: diode
D17: diode
D18: diode
D19: diode
D20: diode
D21: diode
D22: diode
D23: diode
D24: diode
R1: res; {R}
R2: res; {R}
R3: res; {R}
R4: res; {R}
R5: res; {R}
S7: sw; ""
S8: sw; ""
S9: sw; ""
S10: sw; ""
S11: sw; ""
S12: sw; ""
Named nets: Vcc, KEY1, ROW1, COL1, DIG1, 0, KEY2, ROW2, COL2, DIG2, ROW_ON, DIG_ON, COL_ON, ROW_1, COL_1, DIG_1, ROW_2, COL_2, DIG_2
.model SW SW(Vt=0.1)
.param R=12k
.tran 0.5
V2 ROW1 0 PULSE(0 0 0 0 0 0 0 1)
V1 VCC 0 3.3
V3 COL1 0 PULSE(0 0.2 50m 0 0 50m 0 1)
V4 DIG1 0 PULSE(0 0 0 0 0 0 0 1)
V5 ROW2 0 PULSE(0 0.2 150m 0 0 50m 0 1)
V6 COL2 0 PULSE(0 0 0 0 0 0 0 1)
V7 DIG2 0 PULSE(0 0.2 250m 0 0 50m 0 1)
Off inputs
Active input sequence
Pull-up characteristics
Button model
Simulation
