j-silv/FPGA-based-Sudoku/LTspice/LED_driver/Draft1.asc

C1: cap
C2: cap
Q1: npn
Q2: npn
R1: res
R2: res
R3: res
R4: res
V1: voltage
Named nets: 0, Vcc
