j-silv/FPGA-based-Sudoku/(list of files, drawings)

Other design files:
altium/Source/connectors.SchDoc
altium/Source/display.SchDoc
altium/Source/keyboard.SchDoc
altium/Source/miscellaneous.SchDoc
altium/Source/sudoku.PrjPcb
