j-silv/FPGA-based-Sudoku/HDL/ledseg_encoder.vhd

--------------------------------------------------------------------
-- LED segment encoder
--------------------------------------------------------------------

--------------------------------------------------------------------
-- the keyboard data is encoded in binary to represent 
-- LED digit values
--------------------------------------------------------------------

library ieee;
use ieee.numeric_std.all, 
	ieee.std_logic_1164.all;

entitY ledseg_encoder is
	port( 
		D :  in std_logic_vector(9 downto 0);
		Q : out std_logic_vector(7 downto 0)	
	);
end entity ledseg_encoder;

architecture comCathode of ledseg_encoder is
	-- this array contains the associated LED segment data in hexadecimal for
	-- clearing and displaying numerical digits 1-9 for a common cathode 7 segment display
	-- order of segments = DP, G, F, E, D, C, B, A
	type SEG_DATA is array (0 to 9) of std_logic_vector (7 downto 0);
	constant DISPLAY_DIGIT : SEG_DATA:=(
		"00000000", -- CLR the digit (all bits turned off)
		"00000110", -- Display "1" 
		"01011011", -- Display "2"
		"01001111", -- ...
		"01100110",
		"01101101",
		"01111101",
		"00000111",
		"01111111",
		"01101111" -- Display "9"
	);
begin
	encode : process(D) is	
	begin
		case D is
			when "1111111110" => -- (user presses CLR on keyboard)
			Q(7 downto 0) <= DISPLAY_DIGIT(0);
			when "1111111101" => -- (user presses "1" on keyboard)
			Q(7 downto 0) <= DISPLAY_DIGIT(1);
			when "1111111011" => -- etc.
			Q(7 downto 0) <= DISPLAY_DIGIT(2);
			when "1111110111" =>
			Q(7 downto 0) <= DISPLAY_DIGIT(3);
			when "1111101111" =>
			Q(7 downto 0) <= DISPLAY_DIGIT(4);
			when "1111011111" =>
			Q(7 downto 0) <= DISPLAY_DIGIT(5);
			when "1110111111" =>
			Q(7 downto 0) <= DISPLAY_DIGIT(6);
			when "1101111111" =>
			Q(7 downto 0) <= DISPLAY_DIGIT(7);
			when "1011111111" =>
			Q(7 downto 0) <= DISPLAY_DIGIT(8);
			when "0111111111" =>
			Q(7 downto 0) <= DISPLAY_DIGIT(9);
			when others =>
			Q(7 downto 0) <= x"00"; -- no digit is displayed by default
		end case;
	end process;
end architecture comCathode;
