j-silv/FPGA-based-Sudoku/HDL/fsm.vhd

--------------------------------------------------------------------
-- FSM controller
--------------------------------------------------------------------

--------------------------------------------------------------------
-- handles all the control signals, such as output enabling 
-- and write/read control for RAM

-- in charge of circulating information between hardware components 
-- and regulating access to memory.
--------------------------------------------------------------------

library ieee;
use ieee.std_logic_1164.all;

entity fsm is
	port(
		BOUNCE_DONE : in std_logic; -- status of debounce counter
		DELAY_DONE 	: in std_logic; -- status of input timeout
		KEY_DONE 	: in std_logic; -- status of number of distinct keyboard inputs detected
		CLK		 	: in std_logic; -- state changes occur on the rising_edge of this input
		RESET	 	: in std_logic; -- reset FSM to initial state
		COL_ON 		: in std_logic; -- column input detected
		ROW_ON 		: in std_logic; -- row input detected
		DIG_ON		: in std_logic; -- digit input detected

		
		BOUNCE_RST  : out std_logic; -- reset the debounce counter
		DELAY_RST 	: out std_logic; -- reset the input timeout
		KEY_CNT		: out std_logic; -- increment the number of distinct keyboard inputs detected
		KEY_RST		: out std_logic; -- set the number of distinct keyboard inputs detected to 0
		ADDR_CNT 	: out std_logic; -- enable the address counter to increment its current count
		SHIFT_EN 	: out std_logic; -- enable the shift register stages to internally shift data
		RAM_WR 		: out std_logic; -- set the RAM to write mode
		ROW_EN 		: out std_logic; -- enable the row register to latch in user input
		COL_EN 		: out std_logic; -- enable the column register to latch in user input
		ADDR_OE 	: out std_logic; -- enable the address counter to take control of the RAM address line
		REG_OE 		: out std_logic; -- enable the position register to take control of the RAM address line
		DIG_EN 		: out std_logic  -- enable the LED segment data register to latch in user input
	);
end entity;

architecture logic of fsm is
	-- for visibility, build an enumerated type for the state machine
	type state_type is (s0, s1, s2, s3, s4, s5, s6, s7, s8, s9);

	-- register to hold the current state
	signal state : state_type;
begin
	-- logic to advance to the next state
	process (CLK, RESET)
	begin
		-- complete reset (asynchronous)
		if RESET = '1' then
			state <= s0;
		-- otherwise, follow ASM diagram flow 
		-- determine next state based on current states and inputs
		elsif (rising_edge(CLK)) then
			case state is
				when s0 =>
					-- the ON signals have to be inverted because
					-- these signals are pulled up high normally
					if ((NOT(COL_ON) OR NOT(ROW_ON) OR NOT(DIG_ON)) = '1') then
						state <= s1;
					elsif DELAY_DONE = '1' then
						state <= s2;
					else
						state <= s0;
					end if;
				
				when s2 =>
					state <= s0;
					
				when s1 =>
					state <= s3;
				
				when s3 =>
					if BOUNCE_DONE = '1' then
						if COL_ON = '0' then
							state <= s4;
						elsif ROW_ON = '0' then
							state <= s5;
						elsif DIG_ON = '0' then
							state <= s6;						
						else 
							state <= s0;
						end if;
					else
						state <= s3;
					end if;
				
				when s4 =>
					state <= s7;
					
				when s5 =>
					state <= s7;
					
				when s6 =>
					state <= s7;

				when s7 =>
					if ((NOT(COL_ON) OR NOT(ROW_ON) OR NOT(DIG_ON)) = '1') then
						state <= s7;
					elsif KEY_DONE = '0' then
						state <= s0;
					else
						state <= s8;
					end if;
		
				when s8 =>
					state <= s9;
				
				when s9 =>
					state <= s0;
			end case;
		end if;
	end process;

	process (state)
	begin
		-- outputs for each state as shown in the ASM diagram
		case state is
			when s0 =>
				COL_EN 		<= '0';
				ROW_EN 		<= '0';
				DIG_EN 		<= '0';
				REG_OE 		<= '0';
				DELAY_RST 	<= '0';
				KEY_CNT		<= '0';
				KEY_RST		<= '0';
				ADDR_CNT 	<= '1';
				ADDR_OE 	<= '1';
				RAM_WR 		<= '0';
				SHIFT_EN 	<= '1';
				BOUNCE_RST  <= '0';
				
			when s1 =>
				COL_EN 		<= '0';
				ROW_EN 		<= '0';
				DIG_EN 		<= '0';
				REG_OE 		<= '0';
				DELAY_RST 	<= '0';
				KEY_CNT		<= '0';
				KEY_RST		<= '0';
				ADDR_CNT 	<= '1';
				ADDR_OE 	<= '1';
				RAM_WR 		<= '0';
				SHIFT_EN 	<= '1';
				BOUNCE_RST  <= '1';
	
			when s2 =>
				COL_EN 		<= '0';
				ROW_EN 		<= '0';
				DIG_EN 		<= '0';
				REG_OE 		<= '0';
				DELAY_RST 	<= '0';
				KEY_CNT		<= '0';
				KEY_RST		<= '1';
				ADDR_CNT 	<= '1';
				ADDR_OE 	<= '1';
				RAM_WR 		<= '0';
				SHIFT_EN 	<= '1';
				BOUNCE_RST  <= '0';
	
			when s3 =>
				COL_EN 		<= '0';
				ROW_EN 		<= '0';
				DIG_EN 		<= '0';
				REG_OE 		<= '0';
				DELAY_RST 	<= '0';
				KEY_CNT		<= '0';
				KEY_RST		<= '0';
				ADDR_CNT 	<= '1';
				ADDR_OE 	<= '1';
				RAM_WR 		<= '0';
				SHIFT_EN 	<= '1';
				BOUNCE_RST  <= '0';
				
			when s4 =>
				COL_EN 		<= '1';
				ROW_EN 		<= '0';
				DIG_EN 		<= '0';
				REG_OE 		<= '0';
				DELAY_RST 	<= '0';
				KEY_CNT		<= '1';
				KEY_RST		<= '0';
				ADDR_CNT 	<= '1';
				ADDR_OE 	<= '1';
				RAM_WR 		<= '0';
				SHIFT_EN 	<= '1';
				BOUNCE_RST  <= '0';

			when s5 =>
				COL_EN 		<= '0';
				ROW_EN 		<= '1';
				DIG_EN 		<= '0';
				REG_OE 		<= '0';
				DELAY_RST 	<= '0';
				KEY_CNT		<= '1';
				KEY_RST		<= '0';
				ADDR_CNT 	<= '1';
				ADDR_OE 	<= '1';
				RAM_WR 		<= '0';
				SHIFT_EN 	<= '1';
				BOUNCE_RST  <= '0';
				
			when s6 =>
				COL_EN 		<= '0';
				ROW_EN 		<= '0';
				DIG_EN 		<= '1';
				REG_OE 		<= '0';
				DELAY_RST 	<= '0';
				KEY_CNT		<= '1';
				KEY_RST		<= '0';
				ADDR_CNT 	<= '1';
				ADDR_OE 	<= '1';
				RAM_WR 		<= '0';
				SHIFT_EN 	<= '1';
				BOUNCE_RST  <= '0';
				
			when s7 =>
				COL_EN 		<= '0';
				ROW_EN 		<= '0';
				DIG_EN 		<= '0';
				REG_OE 		<= '0';
				DELAY_RST 	<= '1';
				KEY_CNT		<= '0';
				KEY_RST		<= '0';
				ADDR_CNT 	<= '1';
				ADDR_OE 	<= '1';
				RAM_WR 		<= '0';
				SHIFT_EN 	<= '1';
				BOUNCE_RST  <= '0';
				
			when s8 =>
				COL_EN 		<= '0';
				ROW_EN 		<= '0';
				DIG_EN 		<= '0';
				REG_OE 		<= '1';
				DELAY_RST 	<= '0';
				KEY_CNT		<= '0';
				KEY_RST		<= '1';
				ADDR_CNT 	<= '0';
				ADDR_OE 	<= '0';
				RAM_WR 		<= '1';
				SHIFT_EN 	<= '1';
				BOUNCE_RST  <= '0';
				
			when s9 =>
				COL_EN 		<= '0';
				ROW_EN 		<= '0';
				DIG_EN 		<= '0';
				REG_OE 		<= '0';
				DELAY_RST 	<= '0';
				KEY_CNT		<= '0';
				KEY_RST		<= '0';
				ADDR_CNT 	<= '1';
				ADDR_OE 	<= '1';
				RAM_WR 		<= '0';
				SHIFT_EN 	<= '0';
				BOUNCE_RST  <= '0';
				
		end case;
	end process;
end logic; 
