j-silv/FPGA-based-Sudoku/(commit log)

2020-07-05 Create position encoder
2020-07-05 Rename encoderPosition.vhd to VHDL components/encoderPosition.vhd
2020-08-12 Setup directory
    Create a folder for each subset of the Sudoku design, such as
    a folder for schematics, a folder for HDL files, testbenches, etc.
    Also create a text file for each folder that explains their purpose
    and what sort of files will be included.
2020-08-12 Update key_counter component by simplifying ports
    At this point, I realized that I didn't need to have a counter that
    had outputs that dictate the current count (pins Q). The count could be
    kept track of with a "tick" variable directly in the process
    This simplifies the associated VHDL code
    [key_counter.vhd]
2020-08-12 Get rid of output enable signal
    For the current design, the LED segment register is the only device
    that is accessing the RAM data line. There is thus no need for tri-state
    output for the LED segment register
    In the future, another bus multiplexer might be implemented because of
    the ROM module which will have to write to the RAM. However, an output
    enable signal is still not necessary for the LED segment register block.
2020-08-12 Modify column selection code for the combinational circuit
    A 9th bit is included in the with, select statement. This is so that
    when the RAM write cycle occurs, the addr_decoder will not "see" the position register
    output and enable an arbitrary column
    For more information, see source comments
2020-08-12 Create a single component for shifting out LED segment data
    Instead of having a shift register component that does parallel in, parallel
    out shifting and then creating an entity that port maps 8 of these
    components together, I figured it was much simpler to create a 8 stage shift
    register stage directly
    Also get rid of unnecessary serial shifting ports and functionality, since the
    final design will be parallel in and parallel out
    Finally, a concise array is used for indicating each shift register stage
2020-08-12 Explicitly state each shift register stage instead of using an array
    Although this method is less concise, intuitive, and simple to code,
    because the individual components are interconnected via schematic entry,
    I need to separately access the shift register stage outputs
    Quartus II turns the 2D array into an array of std_logic types, instead of an array
    of std_logic vectors... thus for simulation/debug purposes, this is not ideal
2020-08-12 Include the RAM memory intialization file
    This file is just setup for testing the hardware design and
    verifying that the LED Sudoku grid displays what is loaded into RAM upon boot-up
2020-08-12 Work some more on importing pin assignment scripts
2020-08-12 Update testbench with differently noted output signals
    This update follows an update to the full design schematic (.bdf file)
2020-08-13 Import the schematic for the debugging design
    This is the modular complete design that has 8 output debugging signals
    for the breadboard testing/simulation.
    These signals are almost all of the FSM control signals that are sent
    to the various modules. These outputs are visible via the MAX 10 onboard
    LEDs.
2020-08-13 Change to correct location for debugging schematic
2020-08-13 Import first version of the full design schematic
2020-08-13 Update with various component improvements
    Import single component shift register stage and
    the 8th bit for the address decoder (the output enable signal for
    the address counter).
    This signal will be used for ensuring during the
    write cycle of the RAM module, the column selector does not switch to the
    column set by the position register.
2020-08-13 Update symbol formatting (text size) and add PLL
    When switching the display resolution of my screen, the text in the symbol
    boxes of the previous full_design schematics were crossing the symbol box boundaries.
    This update ensures that the text is contained to its boundary.
    Add a PLL that takes in the 50 MHz onboard clock signal and converts it
    to a 100 kHz clock for the different modules.
2020-08-13 Fix bug - incorrect port ordering for FSM component
    The last version of the full_design schematic was used for ModelSim simulation.
    I was not able to recreate the waveforms obtained from the University Program
    Waveform simulator and I was trying to figure out why. After careful inspection
    of the schematic and observing the erroneous simulation behavior, I realized that the
    COL_ON, ROW_ON, and DIG_ON signals were connected to the incorrect FSM inputs.
    Also an update to the naming convention - bus signals are lower case and bit signals
    are uppercase.
2020-08-13 Add bus mux, clean up signal routing, and use PLL for inverse clock
    This is the schematic where the new bus multiplexer is used instead of
    the tri-state buses internal to the address counter and position register modules.
    Also rearrange the port signals of various modules so that less signals
    intersect with each other in the schematic.
    Also modify the PLL so that 2 module clocks can be obtained that are 180 degrees
    out of phase with each other (CLK and INV_CLK). Before, I thought that the only way to do this was
    by using a NOT gate. However within the IP config interface, it was possible to add the
    phase offset.
2020-08-13 Add open-drain output primitives for the column selection signals
    My initial thought was that by using open drain primitives, a much larger
    current can be sinked by the associated pins. This large current will come
    from all the LED segment lines for each row and for a particular column.
    However, after discovering that the open-drain is essentially a tri-state buffer
    with an inverted output enable signal, I am skeptical on whether or not the max
    current limit is increased. Further investigation is needed.
2020-08-13 Delete all the internal signals for simulation/debug purposes
    This schematic gets rid of all of the internal FSM signals, the address lines,
    encoder signals, etc. as outputs on the schematic. This is because
    these outputs were only used during ModelSim simulation to verify
    the correct functionality of the design.
    What rests is only the inputs and outputs of the actual Sudoku design.
    Another addition was a global RESET signal for the various components.
    This is an inverted reset line because I am using a push button
    that is onboard the MAX 10 FPGA dev board and is active low
    (the button logic state is high when not pressed).
    If further simulation is required, think to revert to the previou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
2020-08-13 Add all the symbol files (.bsf) for top-level schematic entity
2020-08-14 Update full_design schematic with up-to-date HDL modules
    Remove the version tags (_v01 for example) on all the HDL
    symbol blocks in the full_design .bdf file.
    Also cleaned up the signals on the schematic and some wiring/nets.
    Also ran a compilation with the full_design schematic as the top-level
    entity and no issues were found. Pending simulation.
2020-08-14 Update debug full_design schematic with up-to-date HDL modules
2020-08-14 Correct the clock frequency value coming from the PLL
    This constant was previously set at 100 MHz, because this was the frequency
    of a simulation clock using the University Waveform Program
    For the current design, the PLL clock is outputting a 10 kHz clock.
    Thus this is the correct frequency to have when calculating the number
    of clock cycles needed to timeout after a certain moment
    [input_timeout.vhd]
2020-08-15 Add internal signals to schematic for simulation testing
2020-08-15 Replace full_design HDL file with the updated one containing internal signals
    [full_design.vhd]
2020-08-15 Fix Quartus error for output signal as addr_decoder[7..0] and addr_decoder[8]
    [full_design.vhd]
2020-08-15 Fix Quartus error due to bus signal being the same name as the component
    [full_design.vhd]
2020-08-15 Update testbench with the new full_design schematic
2020-08-15 Fix component name to full_design and missing SYS_CLK signal in testbench
    [full_design_all_signals.vhd]
2020-08-15 Attach generics to input_timeout entity for setting timeout length
2020-08-15 Correct mistake from 10 kHz to 100 kHz clock
    [full_design.vhd, input_timeout.vhd, test_input_timeout.vhd]
2020-08-15 Fix the MAX_CLOCK_CYCLE bug in the input_timeout HDL file
    When running simulation, now the DELAY_DONE signal becomes active
    Before, what was happening was that I was performing an integer math
    operation of SECONDS --> MS or more specifically the TIMEOUT/1E+3
    This operation in decimal math would have given 0.001 or 1 ms, but
    in integer math this was turned into "0". This means
    that the MAX_CLOCK_CYCLE would ALWAYS be 0.
    When looking at the VHDL code, I see that I would increment the tick
    variable immediately after the rising_edge call. Thus, the tick variable
    could never = 0. That is why the DELAY_DONE signal is never activated
    [full_design.vhd, input_timeout.vhd]
2020-08-15 Create 2 full_design schematics one with internal signals and one for programming
2020-08-15 Fix schematic and pin assignment script with new decode_in signal name
2020-08-15 Create LTspice simulation for darlington pair LED driver
2020-08-15 Test with external LED driver (ULN2003A)
    Success with slow PLL clock (1.2 kHz). Due to signal switching,
    my ampmeter was unable to obtain an accurate value for the current passing
    through each column once that column is activated.
    However, first visual results seem promising. Also noticed
    during the tests that there that is clearly button bouncing even with the RC circuit.
    Tomorrow I'll work on that and test how much DC current is passing when
    the columns have all their segments lit.
    Other changes - remove open_drain primitives and weak_pull_up assignments
    Also change the address_decoder entity so that when a column is selected,
    it is activated (to select column 1 for example, the output b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
2020-08-16 Test hardware with HDL circuit and update LTspice simulation
    For the 2 row 1 column test, low current values were found going
    through the LED driver when compared to simulation. For more accurate
    results, the datasheet info for the darlington pairs and the LED digits
    should be modeled into SPICE
    With that said, this setup is well within current limitations on FPGA pins
    and further hardware testing will incoroporate these changes (no open-drain
    pins on FPGA, external LED driver circuit, etc.)
    Final test is to use 100 kHz PLL clock with Sudoku design and then this branch
    will be merged into master
2020-08-16 Test hardware with 100 kHz PLL clock and observe luminosity
    Since each column is briefly
    turned on and cycled in the full Sudoku design,
    the *average* current of each column
    branch is significantly lower
    This leads to lower luminositiy levels. For testing purposes this is
    sufficient. However for the final design, a higher current gain driver
    should be used so that more LED current can be sinked for illuminating
    an entire column.
    Branch will be merged in to master since the external LED driver
    feature has been implemented with success.
2020-08-16 Change RC constant of debounce circuit for simulation and test
    Previously, my RC circuit had a resistor value of approximately 100 kohms.
    This value was chosen sort of haphazardedly. After referring to the debouncing
    guide by Jack G. Ganssle, I redid the calculations for choosing
    appropiate resistor values.
    This time, I used the actual Schmitt trigger values of the MAX 10 FPGA
    for calculating the resistor values (notably, the Vih(max) and the Vil(min) values).
    I inserted 1 megaohm resistors which greatly exceed the requirements.
    In LTspice simulation, the threshold voltages are now respected for the average debounce times
    as specified in the debouncing guide by Jack G. Ganssle.
    During the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
2020-08-17 Update to LTspice schematic
2020-08-17 Simulate design with inverted clocks for all blocks except for FSM
    In an effort to debug the hardware and to obtain results similiar to simulation,
    my first idea was to use inverted clocks not only for the registers,
    but also for all components that the FSM controls.
    My thinking was that this will remove the ambiguity between when the FSM control
    signals arrive and when the components make a decision based on the states
    of these control signals.
    In theory, this should improve the low hold times and perhaps
    fix the issues that are arriving when the hardware is tested at
    a PLL clock frequency of 100 kHz.
    As expected, ModelSim yields basically unchanged results: the inverted
    clock shouldn't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
    [full_design.vhd, full_design_all_signals.vhd, full_design_simulation.vhd, input_timeout.vhd]
2020-08-18 Update FSM with states for software debouncing the keyboard buttons
2020-08-18 Create HDL debouncer module and include it in top-level schematic entity
2020-08-18 Update testbench and run simulation with software debouncing
    ModelSim simulation was successful - just like before, the
    appropiate column/row/digit is written to memory
    even with the newly added software debouncing module
    Although the debouncing function was not tested in simulation, this
    can be done in the future by simply writing a test bench that
    simulates the rapid bouncing of the keyboard signals.
    However, since the module acts as a simple delay, this simulation isn't
    necessary for verifying the correct functionality.
    [full_design_all_signals.vhd, full_design_simulation.vhd]
2020-08-18 Update schematic for programming and test hardware with debouncer
    The software debouncer works very well when tested on the hardware
    I am easily able to write 1's and CLR's to the available row/columns
    which was not consistently possible before adding the software debouncing
    Also, since button bouncing was the main issue that was obvious
    from hardware testing, I can happily say that the design works
    on actual hardware. At this point, the associated HDL files
    and schematic give a working prototype for the Sudoku design
2020-08-19 Update TCL script with descriptive comments and simplify code
    Use for loops for assigning logic levels for pin vectors (keyboard_in
    and row_0, row_1 for example)
2020-08-19 Update/simulate LTspice schematic for internal pull-up keyboard topology
2020-08-19 Update input encoders with inverse logic levels for new keyboard design
2020-08-19 Update TCL script for pin assignment and enable input pull-up resistors
2020-08-19 Test hardware with new keyboard design (internal pullups)
    Hardware test was a success. The design works as before when
    there were external pull-down resistors.
    A little bit of troubleshooting was done during testing:
    On the breadboard, I previously had the other keyboard signals connected
    to ground. With the new keyboard design, the keyboard states are now
    pulled high when the buttons are not activated. Thus, since I had
    all the other keyboard signals low, my HDL code for the encoders
    gave a "Don't care" output for the signals going to the registers.
    Another issue - one of my jumper cables that went to the digit "1"
    was not well connected. After changing out this cable I was able
    to write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
    [fsm.vhd, full_design_all_signals.vhd]
2020-08-20 Setup initial RAM contents to display Sudoku upon power-up
2020-08-20 Update ULN2003A LTspice schematic and choose circuit values
    For the final design, 2 ULN2003A ICs will be used to drive
    the Sudoku grid and its column lines. A series resistor of
    100 ohms or less will be included for each LED segment line
    which after simulation will give approximately
    3-4 mA for each LED segment pin.
    This should give a display that's bright enough, but further
    testing can be done once the board is complete
2021-05-31 Commit the leftover modifications that I didn't commit...
    [full_design_simulation.vhd]
2021-05-31 Attempt to add altium files with specific gitignore inclusion/exclusion
    [sudoku.PrjPcb, sudoku.SchDoc]
2021-05-31 Use pin swapper optimizer for edge connector and headers
    [sudoku.PrjPcb, sudoku.SchDoc]
2021-05-31 Fix error on schematic with KEY9 net and deal with extra pin errors...
    I think because I went ahead and swapped the pins within the PCB view, there were some issues
    since the schematic library part (J2, J3, edge connector, etc.) do not have the same pinout.
    I believe I fixed it though - no validation errors either on the schematic or PCB, and all connection
    net signals are on the same layer. Only the GND nets go from top layer to bottom layer.
    [sudoku.PrjPcb, sudoku.SchDoc]
2021-06-01 Kind of a mess with the pin swapper and synchronizing pins between schematic and PCB. Seems to work now
    [sudoku.SchDoc]
2021-06-01 Routing for keyboard perimeter
    [sudoku.SchDoc]
2021-06-01 Add extra pins in tactile button library and push to schematic/PCB
    [sudoku.PrjPcb, sudoku.SchDoc]
2021-06-01 Routing for columns from LED matrix
2021-06-01 Finish connecting all columns from LED matrix
2021-06-01 Start routing for edge connector to resistors
2021-06-02 Reorganize again, digit selection buttons
    [sudoku.PrjPcb, sudoku.SchDoc]
2021-06-03 Reduce width of layout and swap diodes to bottom layer
2021-06-03 Optimize resistor placement for LED segs
    [sudoku.SchDoc]
2021-06-03 Fine grid snap LED seg resistors
2021-07-11 Fix issues with pin swapping on FPGA connectors
    The nets weren't being registered because I didn't have a wire
    connecting the resistors to the jumper header connectors.
    Also, realized that I was incorrectly naming the header parts pins ->
    since the FPGA headers are added with jumper wires, I can pin swap
    all the pins on the PCB headers and these headers shouldn't have any names.
    I added at the bottom of the schematic an explanation of this, hopefully it
    makes sense. Essentially, as long as each header isn't exceeding the number of pins
    available from the FPGA headers, we can swap all the pins around on the PCB and
    afterwards just connect the corresponding jumper wires after pin configurati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
    [sudoku.SchDoc]
2021-07-18 Rearrange row resistors to fit signal routing
    [sudoku.PrjPcb, sudoku.SchDoc]
2021-07-18 Finish edge connector routing - use vias for unavoidable crossing
    [sudoku.SchDoc]
2021-07-18 Quickly route 'key' nets
    There is a slight issue with synchronization between the schematic and the PCB.
    I think this is because I swapped pins on the PCB and then starting routing nets, but
    didn't push changes to schematic after swapping. One net example is J-23 and J-24. If
    I cross probe one of those nets the incorrect net is highlighted on the schematic
    and the PCB. This might be manually resolved but I'm not sure of the best way to do that
    (match nets? Generate custom ECO?)
    Things left to route -> all the extra game options (and LEDs associated),
    the KEY[9..0] bus, the LED column signals, power and ground,
    and the DIG_ON, COL_ON, and ROW_ON.
    [sudoku.SchDoc]
2021-07-24 Add mounting M3 mounting holes and round off board
    [sudoku.SchDoc]
2021-07-24 Route LEDCOL signals, connect COL signals, initially layout key bus, update UI labels
    [sudoku.SchDoc]
2021-07-24 Finish routing up key bus, and add 'how to play' game label section
    [sudoku.SchDoc]
2021-07-24 Finish routing signals (game options)
    [sudoku.SchDoc]
2021-08-01 Separate schematic into distinct pages, remove old notes
    [connectors.SchDoc, display.SchDoc, keyboard.SchDoc, miscellaneous.SchDoc, sudoku.PrjPcb, sudoku.SchDoc]
2021-08-07 Fix naming LED#ROW#, clean up connectors, add net names
    Realized that every bus had the opposite designator for the bus, that is to say
    that each entry to the bus should be LED0, LED1... etc. instead of ROW0, ROW1, etc.
    Got rid of the non-generic headers and replaced them with simple 20x2 headers from
    Altium Library. Also matched snap grid and aligned, so that attaching the components and
    nets was much easier.
    Finally, added descriptive net names for connectors between resistors. This is for
    synchronizing the PCB and schematic (errors due to mismatch after pin swapping).
    [connectors.SchDoc, display.SchDoc]
2021-08-07 Synchronize schematic and PCB
    I'm pretty sure all the synchronization is done, as I've run update schematic to
    PCB and vice versa with no changes to report (except for Room definitions). Hopefully
    all the nets are in the right place, which I'm fairly confident about since the schematic
    doesn't show any issues with how the PCB is routed.
    [connectors.SchDoc, miscellaneous.SchDoc, sudoku.PrjPcb]
2021-08-08 Add overlay for testpoints, start transferring game labels
    [sudoku.PrjPcb]
2021-08-08 Work through ERC violations - update PCB libraries
    [miscellaneous.SchDoc]
2021-08-08 Waive SW nets, copper pour top/bot for GND/VCC, waive edge connector VCC
    Check DRC, no unwaived violations. Waived violations include the redundant net
    connections for the switches (internally connected), and the edge connector not
    reaching VCC for 2 pins. The latter isn't necessary because the MAX10 board already has
    all those VCCs connected.
    Small section for VCC on top layer.
2021-08-14 Align and clean up top silk, set height:width -> 6:1
    [sudoku.PrjPcb]
2021-08-14 Update title block in sch, via stitch and move off top/bottom silk
    [connectors.SchDoc, display.SchDoc, keyboard.SchDoc, miscellaneous.SchDoc, sudoku.PrjPcb]
2021-08-14 Add +/- on bottom overlay for LEDs
    [sudoku.PrjPcb]
2021-08-14 Output schematics/PCB into pdfs and png imgs
2021-08-15 Update images and all docs with author name
    [connectors.SchDoc, display.SchDoc, keyboard.SchDoc, miscellaneous.SchDoc, sudoku.PrjPcb]
2021-10-25 Update altium project and create excel for pin mapping
    [connectors.SchDoc, fpga_pins.xlsx, miscellaneous.SchDoc, sudoku.PrjPcb]
2021-10-28 Initially test PCB with appropiate pin setting and test code
    [fpga_pins.xlsx]
2021-10-29 Test PCB with reversed edge connector, write macro for pin mapping
    Some LEDROW segments on edge connector still seem to be disconnected,
    and seems that column selection (LEDCOL0, 1, etc.) is reversed somewhere on jumper
    connectors. Pending pin verification on LEDCOL lines and segments unlit.
    [fpga_pins.xlsm, fpga_pins.xlsx]
2021-11-01 Determine unsoldered/shorted segment lines
    Disconnect these lines from the unusable output pins on the PCB by assigning
    them to the PMOD signals on MAX10 board.
    Rows and columns are not correctly being addressed by button presses.
    Here are some examples of input/output events:
    press ROW8, COL8 -> output @ ROW0, COL0
    press ROW8, COL7 -> output @ ROW0, COL8,
    press ROW8, COL6 -> output @ ROW0, COL7,
    ...
    press ROW8, COL0 -> output @ ROW0, COL1
    press ROW7, COL8 -> output @ ROW8, COL8
    press ROW7, COL7 -> output @ ROW8, COL7
    press ROW7, COL6 -> output @ ROW8, COL6
    ...
    press ROW7, COL0 -> output @ ROW8, COL0
    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
    [fpga_pins.xlsm]
2021-11-01 Replace inferred RAM with quartus IP to view in memory content
    The megafunction RAM block's data can be modified in situ via
    Quartus In system memory editor. Needed to replace HDL block with
    the IP block as per documentation (allowing system memory to be edited
    without a system clock).
    [full_design_all_signals.vhd, ram.vhd]
2021-11-02 Fix bug (shift_out signal 1 clock tick too early)
    To determine what the issue was, I created a simpler ram display block diagram.
    This schema tested the different components associated with displaying the
    LED segment data from GRAM (game ram).
    After testing, it was found that the shift_out signal was shifting out 1 clock too
    early, leading to the bizarre display behavior (row 8 corresponded to row 0, etc.).
    After fixing the shift_out signal, the Sudoku board can be written to without issue
    and the appropiate rows/columns are addressed.
    [addr_counter.vhd, addr_decoder.vhd, clock_divider.vhd, shift_stage.vhd, transparent_decoder.vhd]
2021-11-03 Get all segments working, load mif with preset Sudoku game
    Fixed segment line issues by soldering the appropiate resistors and unshorting
    the edge connector pins. When testing the board with ram loaded with
    only 0xFF, we see all segments illuminated as expected.
    Upon bootup, user can play a Sudoku game that is preloaded with the memory
    initialization file (.mif). Work can now begin on improving software (HDL),
    implementing difficulty settings, new game, check, reset, decimal point display,
    etc. etc.
